TFLVerouden/cough-machine-control/docs/airflow/Valve 2 setpoint current and flow rate relation.pdf

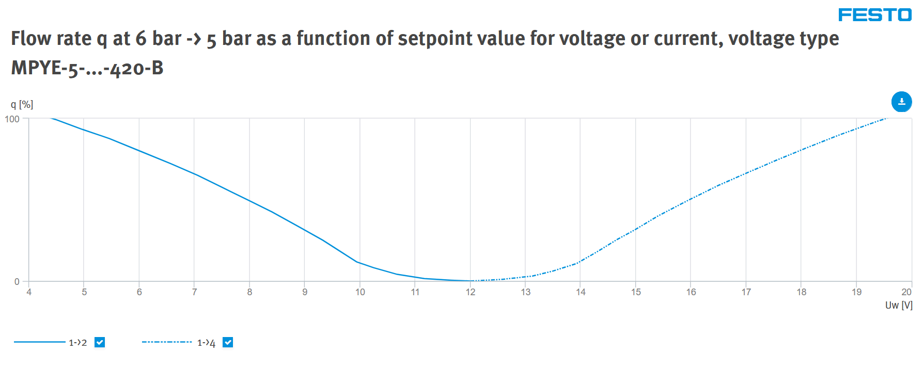
[picture p9: page 1]
