TFLVerouden/cough-machine-control/docs/peripherals/spraytec/SprayTec_support_alarm_at_low_signal.pdf

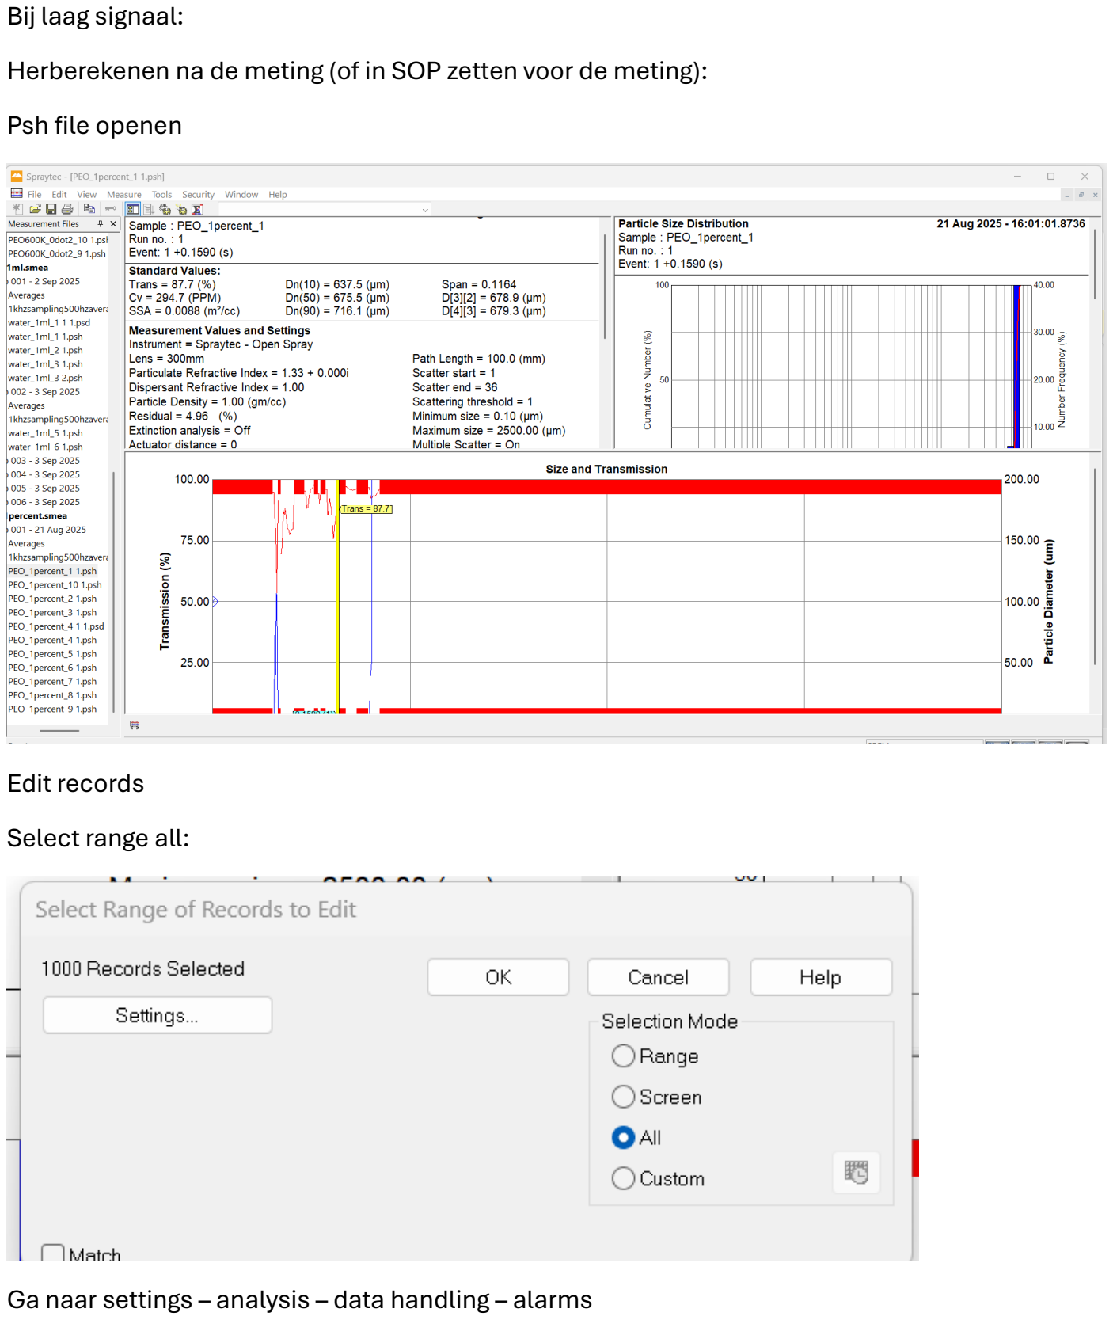
[picture p10: page 1]

Bij laag signaal:
Herberekenen na de meting (of in SOP zetten voor de meting): Psh file openen

Edit records
Select range all:

Ga naar settings – analysis – data handling – alarms

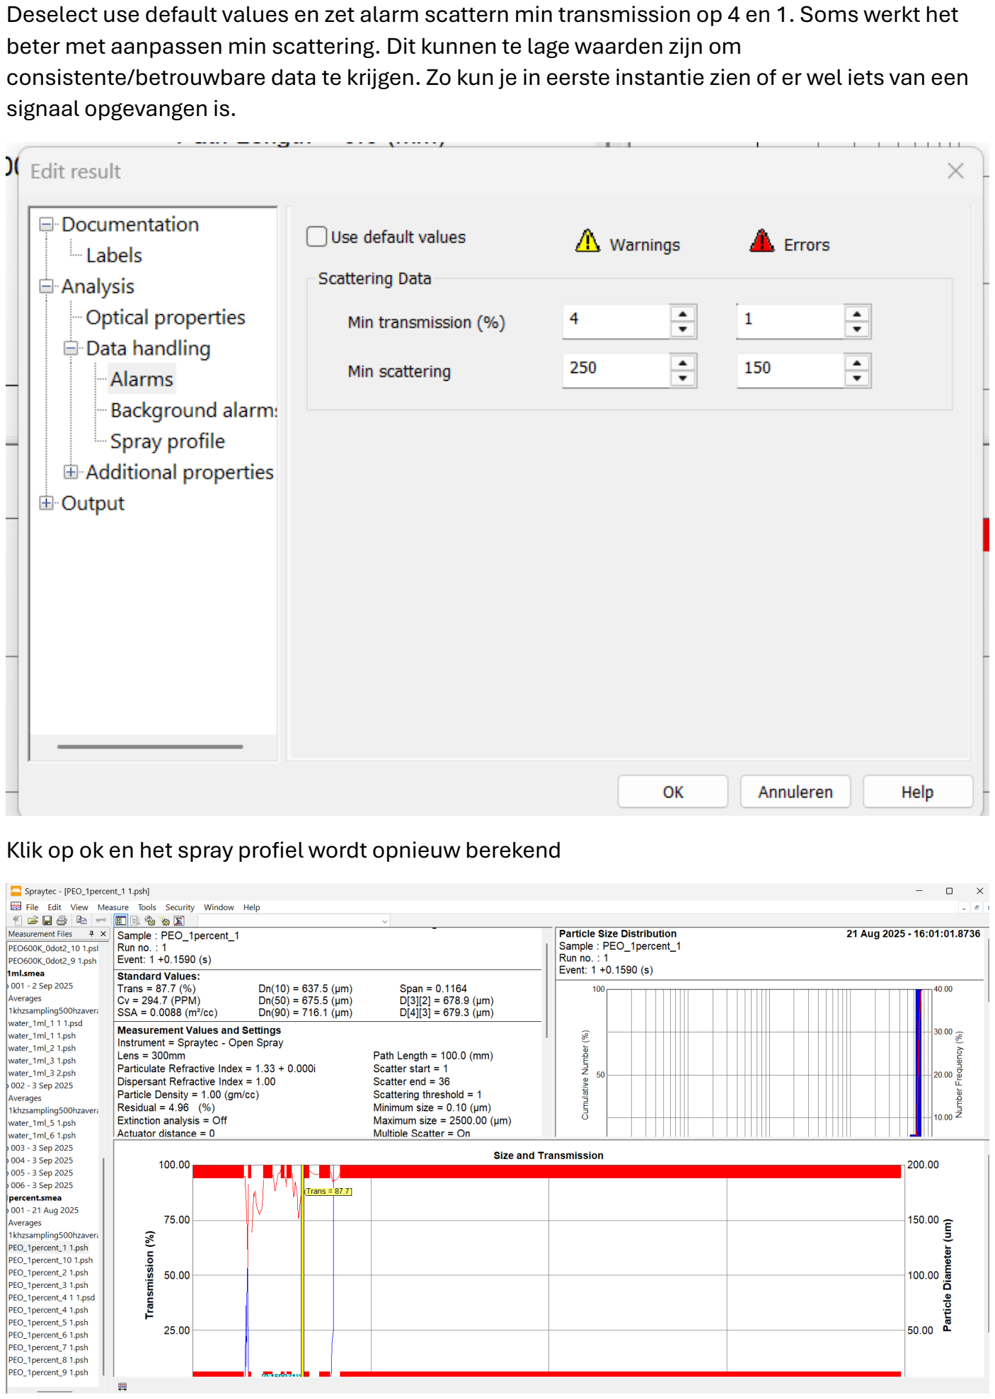
[picture p11: page 2]

Deselect use default values en zet alarm scattern min transmission op 4 en 1. Soms werkt het beter met aanpassen min scattering. Dit kunnen te lage waarden zijn om consistente/betrouwbare data te krijgen. Zo kun je in eerste instantie zien of er wel iets van een signaal opgevangen is.

Klik op ok en het spray profiel wordt opnieuw berekend
