TFLVerouden/cough-machine-control/data_to_local/piv/processed/PIV250723/PIV_1bar_80ms_closedtank/flow_rate.pdf

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

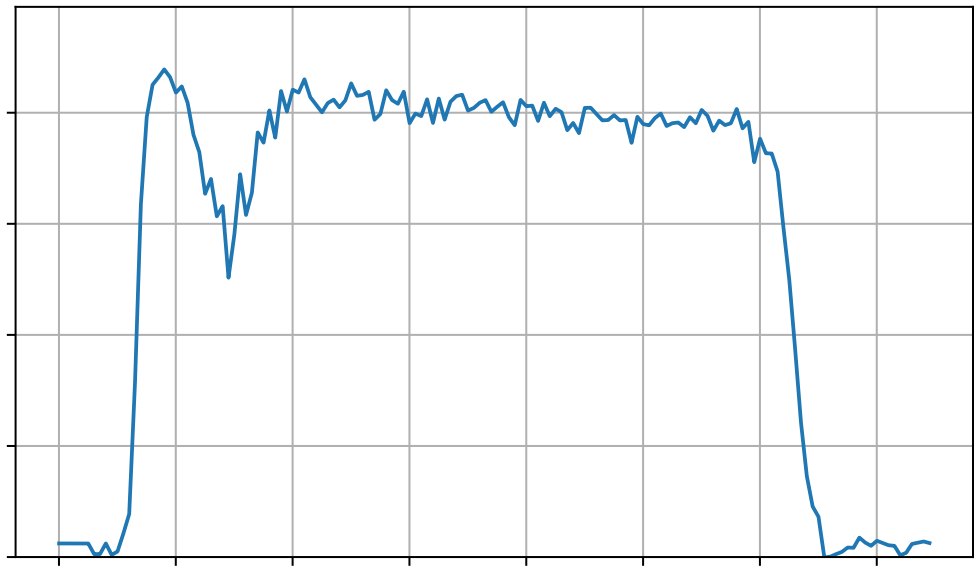
[picture p12: figure]
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
