TFLVerouden/cough-machine-control/archive/Ximea_experimenting/schematic_ximea_code_integration.pptx

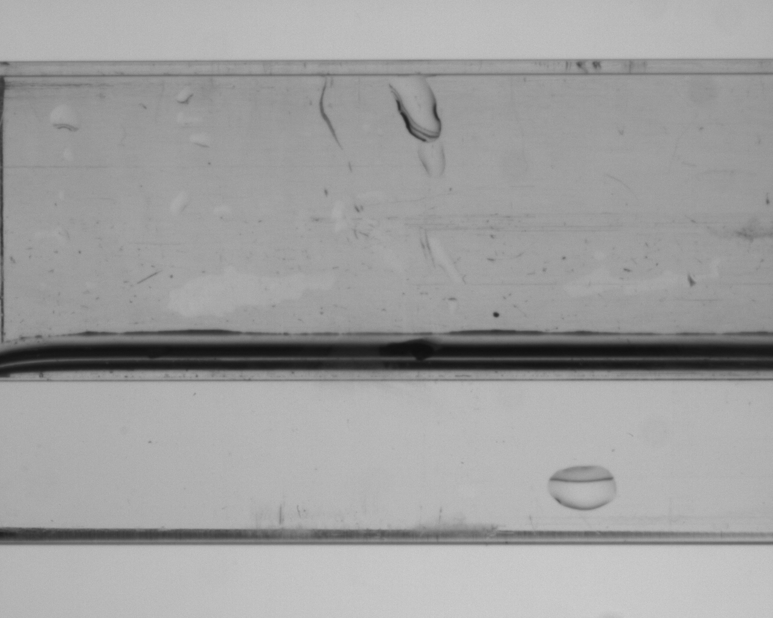
[picture p17: figure]
Afbeelding met Rechthoek, lijn, zwart-wit Door AI gegenereerde inhoud is mogelijk onjuist.

Live view

Valvecontrol

Satisfied? Type save or discard to continue
New question for Name of file

Discarding the live view

Asking to save the cough profile plus duration

Ready to cough?

Now: HS camera on second laptop.
Future? Opening of screen of desktop?
