TFLVerouden/cough-machine-control/data_to_local/valve_control_runs_outputs_to_be_sorted/250515_1322_emptythetank.png

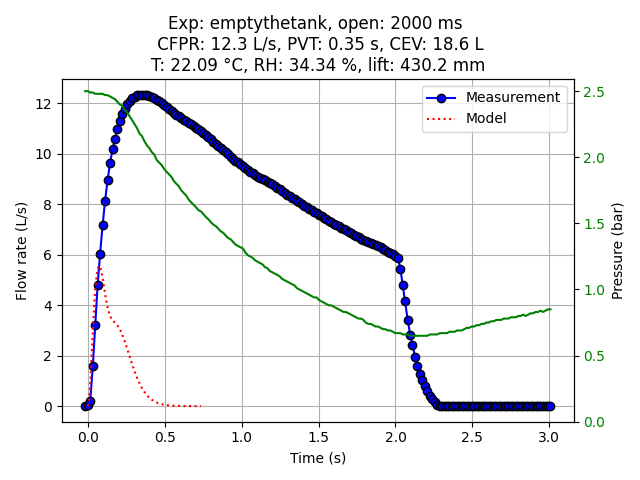
data_to_local/valve_control_runs_outputs_to_be_sorted/250515_1322_emptythetank.png
