TFLVerouden/cough-machine-control/data_to_local/valve_control_runs_outputs_to_be_sorted/250623_1608_PIV2.png

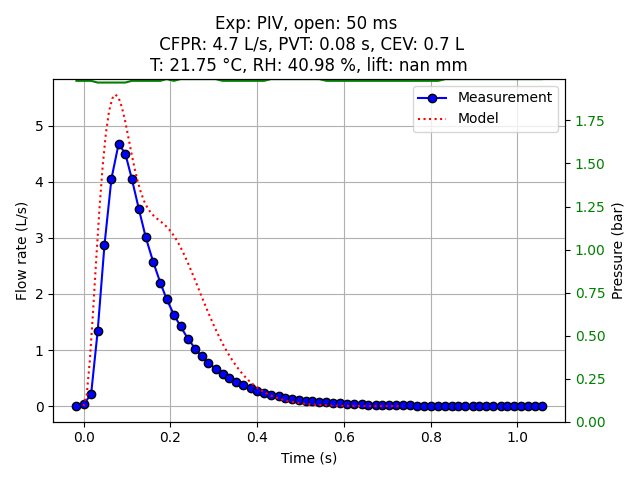
data_to_local/valve_control_runs_outputs_to_be_sorted/250623_1608_PIV2.png
