TFLVerouden/cough-machine-control/data_to_local/valve_control_runs_outputs_to_be_sorted/250624_1115_PIV3.png

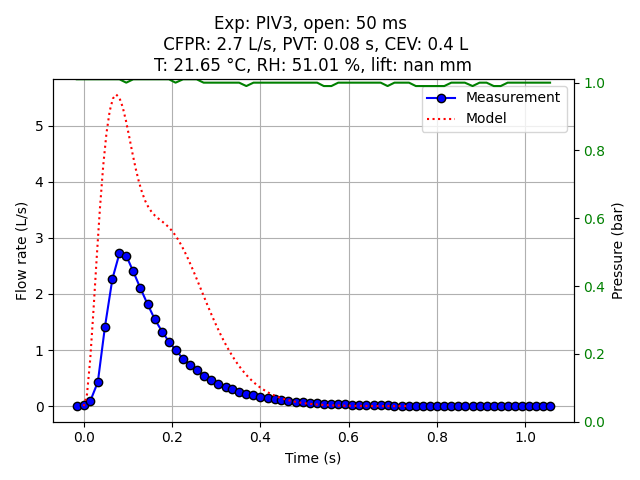
data_to_local/valve_control_runs_outputs_to_be_sorted/250624_1115_PIV3.png
