TFLVerouden/cough-machine-control/data_to_local/valve_control_runs_outputs_to_be_sorted/250624_1323_PIV7.png

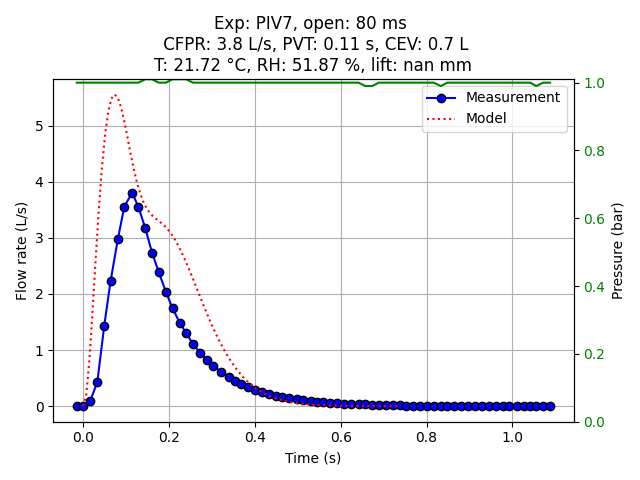
data_to_local/valve_control_runs_outputs_to_be_sorted/250624_1323_PIV7.png
