TFLVerouden/cough-machine-control/data_to_local/valve_control_runs_outputs_to_be_sorted/250626_1431_PIV10.png

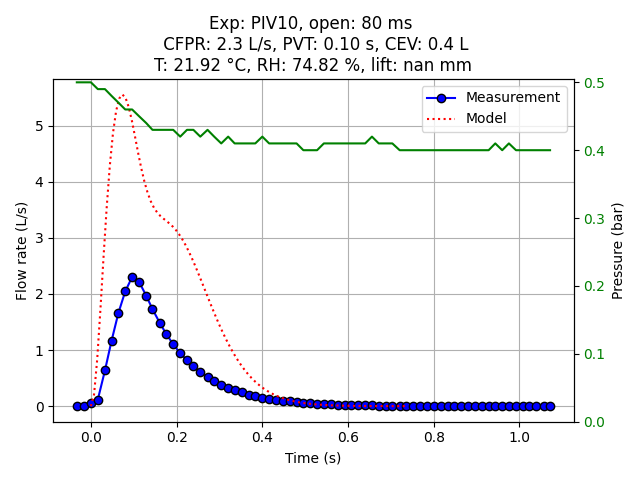
data_to_local/valve_control_runs_outputs_to_be_sorted/250626_1431_PIV10.png
