TFLVerouden/cough-machine-control/data_to_local/valve_control_runs_outputs_to_be_sorted/250626_1444_PIV11.png

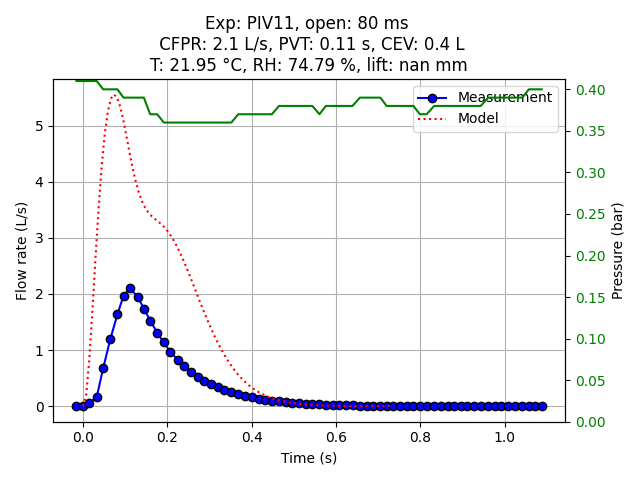
data_to_local/valve_control_runs_outputs_to_be_sorted/250626_1444_PIV11.png
