TFLVerouden/cough-machine-control/data_to_local/valve_control_runs_outputs_to_be_sorted/250704_1403_coughtopview0dot5bar0dot03percent.png

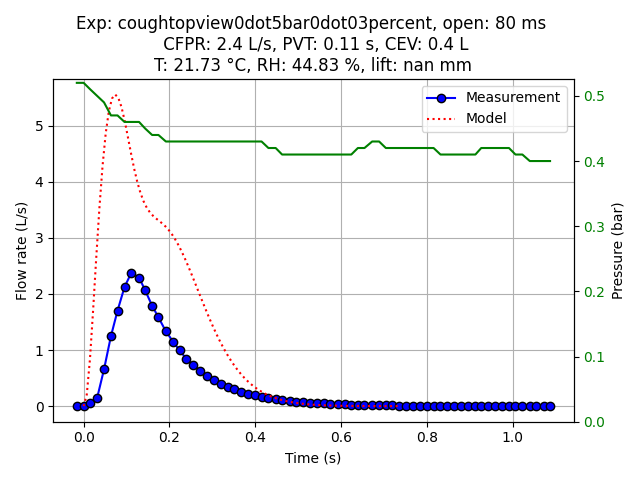
data_to_local/valve_control_runs_outputs_to_be_sorted/250704_1403_coughtopview0dot5bar0dot03percent.png
