TFLVerouden/cough-machine-control/data_to_local/valve_control_runs_outputs_to_be_sorted/250704_1427_cough_topview_0dot03percent_0dot5bar.png

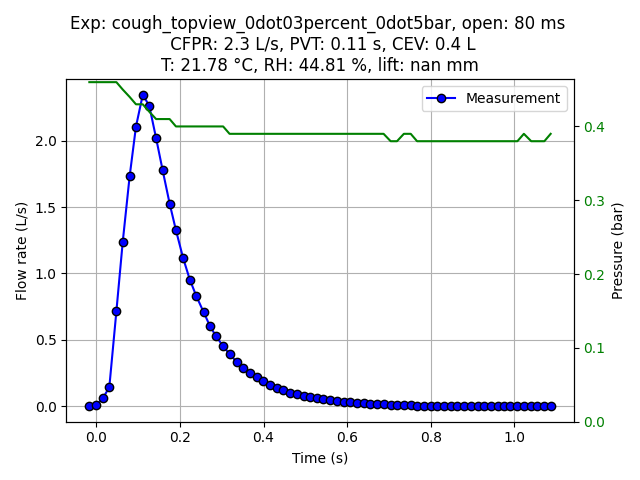
data_to_local/valve_control_runs_outputs_to_be_sorted/250704_1427_cough_topview_0dot03percent_0dot5bar.png
