TFLVerouden/cough-machine-control/data_to_local/valve_control_runs_outputs_to_be_sorted/250723_1517_PIV_1.5bar.png

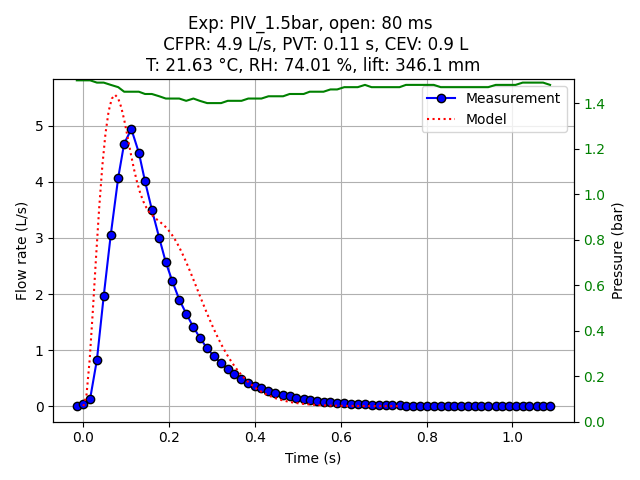
data_to_local/valve_control_runs_outputs_to_be_sorted/250723_1517_PIV_1.5bar.png
