TFLVerouden/cough-machine-control/data_to_local/valve_control_runs_outputs_to_be_sorted/250723_1638_1bar_refill.png

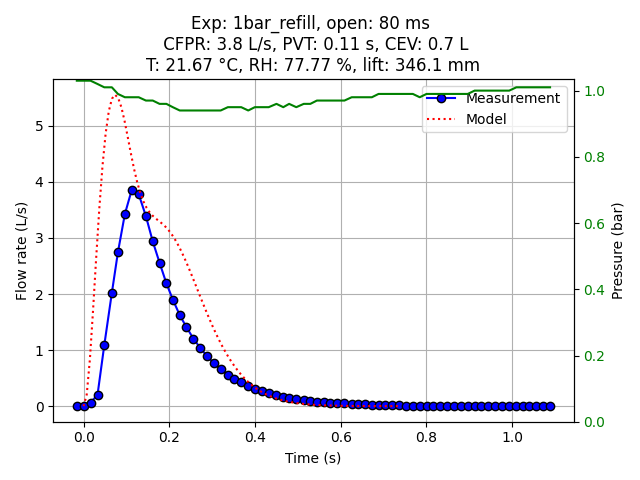
data_to_local/valve_control_runs_outputs_to_be_sorted/250723_1638_1bar_refill.png
