TFLVerouden/cough-machine-control/data_to_local/valve_control_runs_outputs_to_be_sorted/250801_1734_PEO0dot25_1dot5bar_1dot5ml_1.png

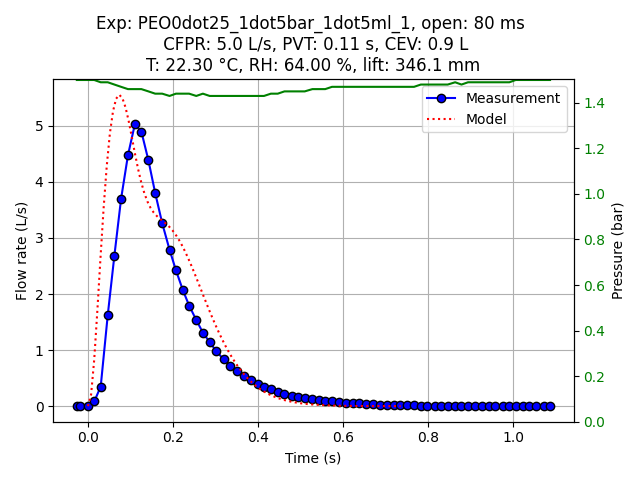
data_to_local/valve_control_runs_outputs_to_be_sorted/250801_1734_PEO0dot25_1dot5bar_1dot5ml_1.png
