TFLVerouden/cough-machine-control/data_to_local/valve_control_runs_outputs_to_be_sorted/250801_1807_1dot5bar_0dot25PEO_1dot5ml_2.png

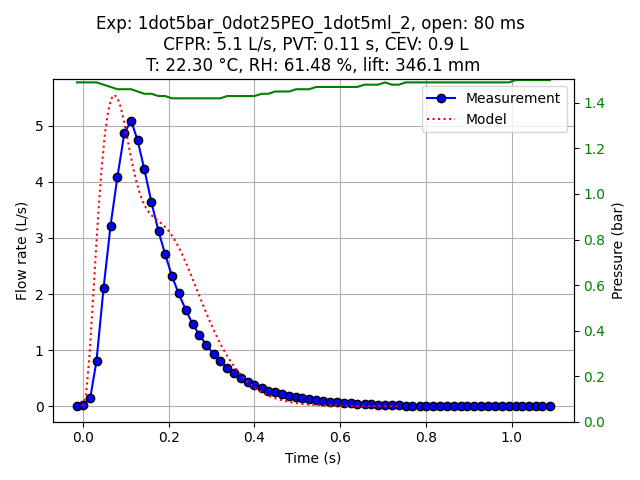
data_to_local/valve_control_runs_outputs_to_be_sorted/250801_1807_1dot5bar_0dot25PEO_1dot5ml_2.png
