TFLVerouden/cough-machine-control/data_to_local/valve_control_runs_outputs_to_be_sorted/250806_1147_PEO_0dot25_10.png

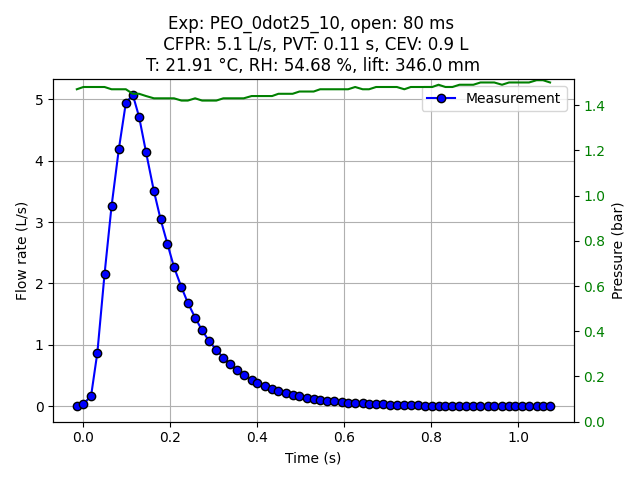
data_to_local/valve_control_runs_outputs_to_be_sorted/250806_1147_PEO_0dot25_10.png
