TFLVerouden/cough-machine-control/data_to_local/valve_control_runs_outputs_to_be_sorted/250807_1512_PEO0dot03_4.png

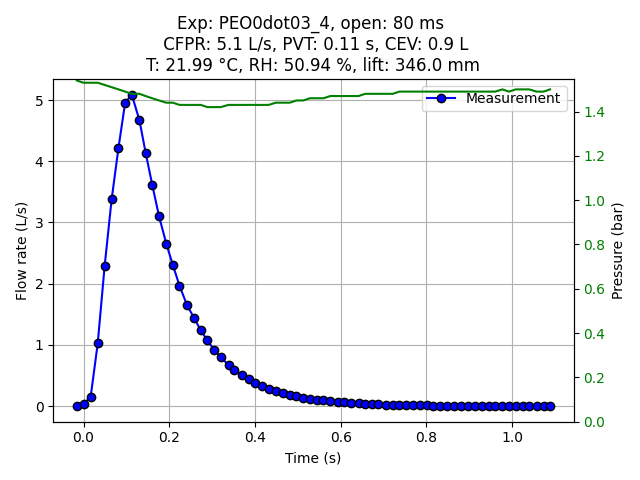
data_to_local/valve_control_runs_outputs_to_be_sorted/250807_1512_PEO0dot03_4.png
