TFLVerouden/cough-machine-control/data_to_local/valve_control_runs_outputs_to_be_sorted/250829_1744_PEO0dot25_0dot5bar_1.png

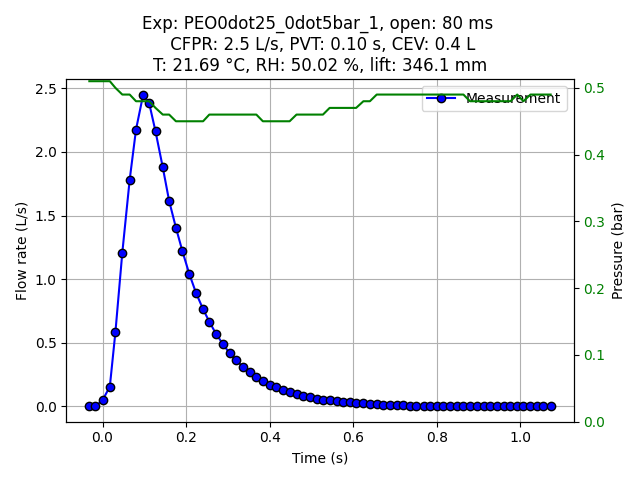
data_to_local/valve_control_runs_outputs_to_be_sorted/250829_1744_PEO0dot25_0dot5bar_1.png
