TFLVerouden/cough-machine-control/data_to_local/valve_control_runs_outputs_to_be_sorted/250829_1811_PEO0dot25_1dot25bar_2.png

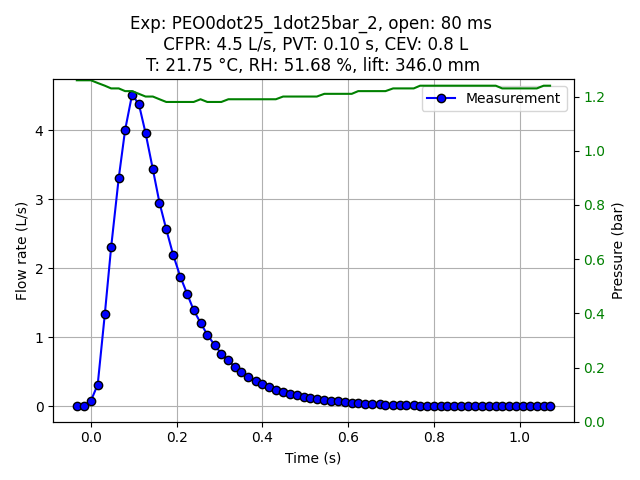
data_to_local/valve_control_runs_outputs_to_be_sorted/250829_1811_PEO0dot25_1dot25bar_2.png
