TFLVerouden/cough-machine-control/docs/electronics/screenshots/Adafruit_ItsyBitsy_M4_crop.PNG

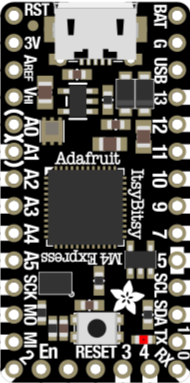
docs/electronics/screenshots/Adafruit_ItsyBitsy_M4_crop.PNG
