TFLVerouden/cough-machine-control/docs/electronics/screenshots/Adafruit_ItsyBitsy_M4_pinout.png

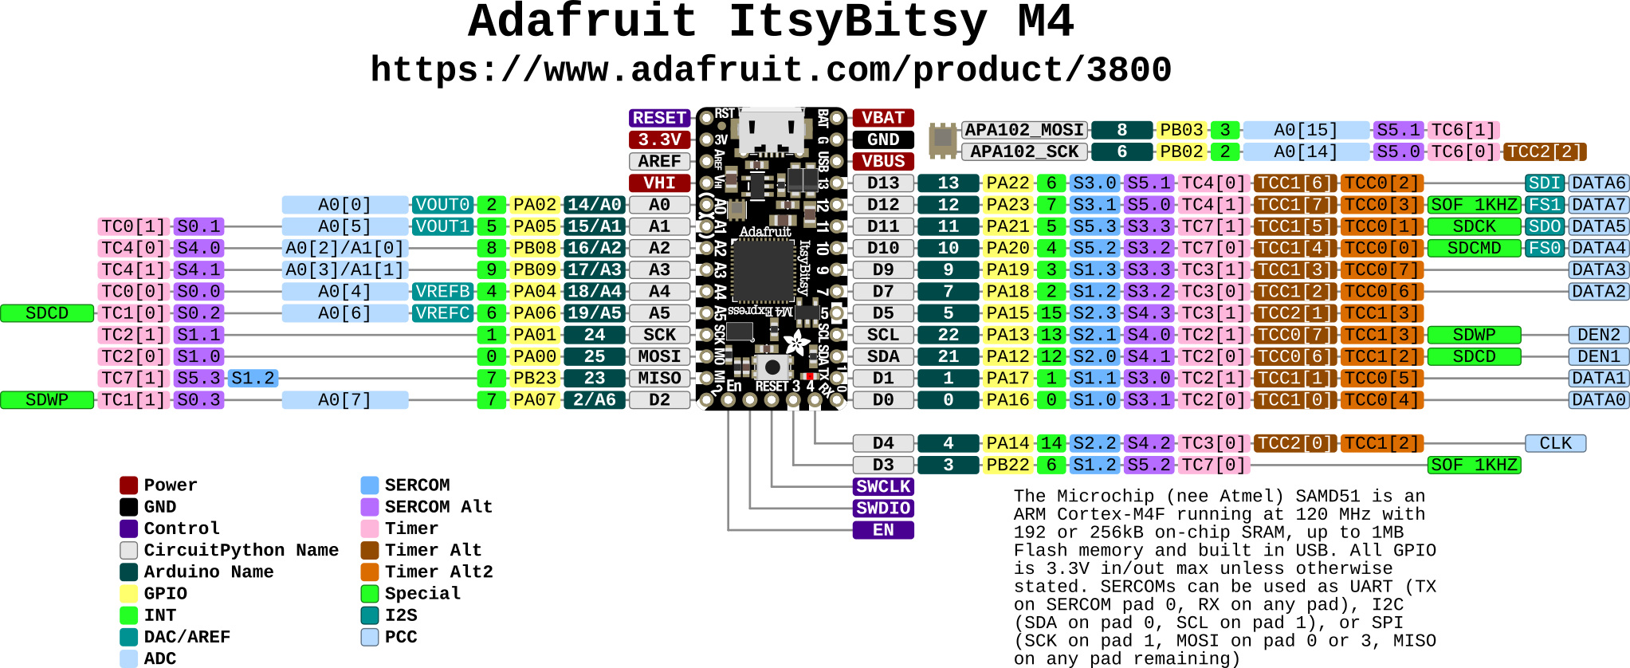
docs/electronics/screenshots/Adafruit_ItsyBitsy_M4_pinout.png
