TFLVerouden/cough-machine-control/docs/electronics/screenshots/Adafruit_Motor-MOSFET_driver_front.jpg

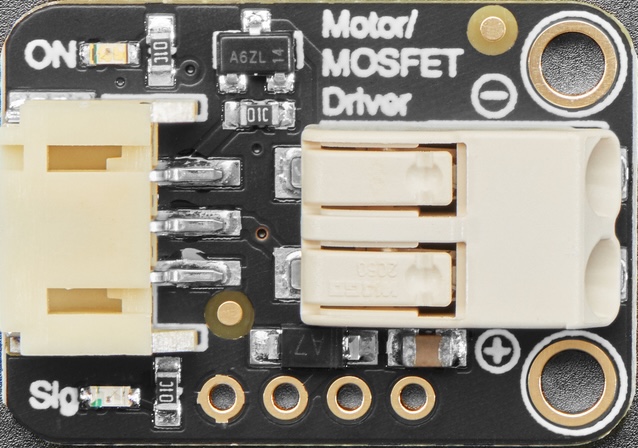
docs/electronics/screenshots/Adafruit_Motor-MOSFET_driver_front.jpg
