TFLVerouden/cough-machine-control/docs/electronics/screenshots/Adafruit_SHT45.jpg

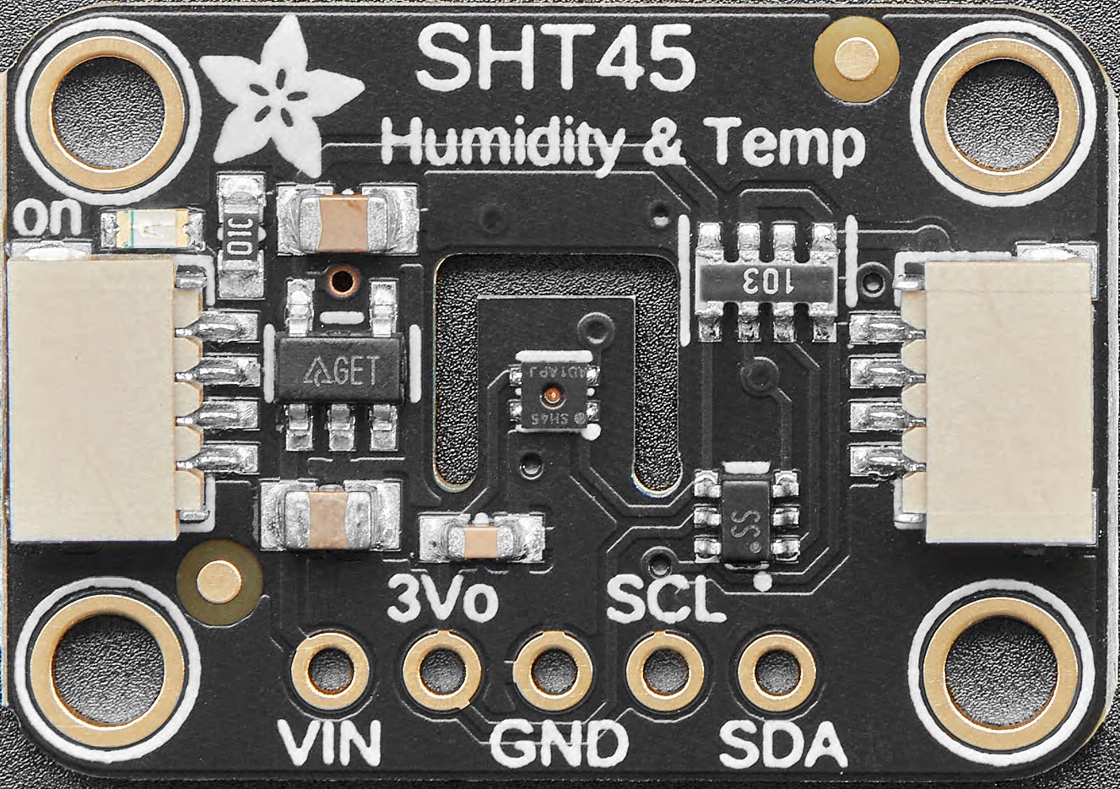
docs/electronics/screenshots/Adafruit_SHT45.jpg
