TFLVerouden/cough-machine-control/docs/electronics/screenshots/MIKROE_420mA_RClick_front.jpg

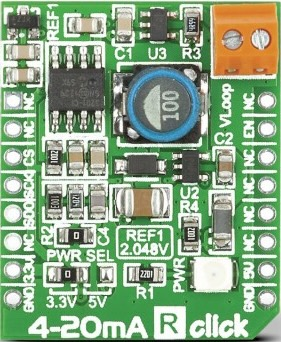
docs/electronics/screenshots/MIKROE_420mA_RClick_front.jpg
