TFLVerouden/cough-machine-control/docs/electronics/screenshots/MIKROE_420mA_TClick_back.jpg

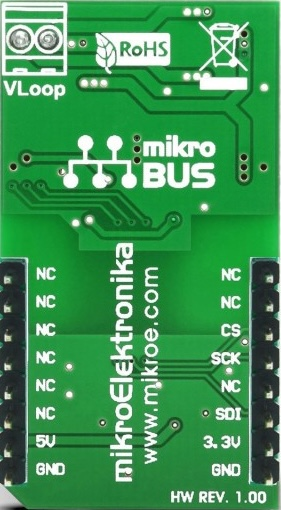
docs/electronics/screenshots/MIKROE_420mA_TClick_back.jpg
