TFLVerouden/cough-machine-control/docs/electronics/screenshots/MIKROE_420mA_TClick_front.jpg

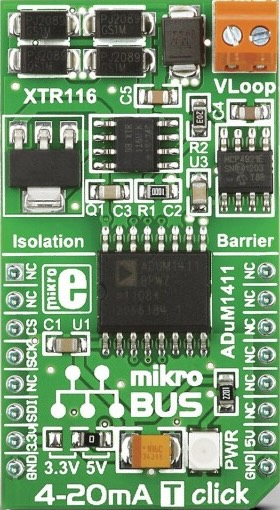
docs/electronics/screenshots/MIKROE_420mA_TClick_front.jpg
