TFLVerouden/cough-machine-control/other_side_stuff/effectofLEDlightonSpraytec.png

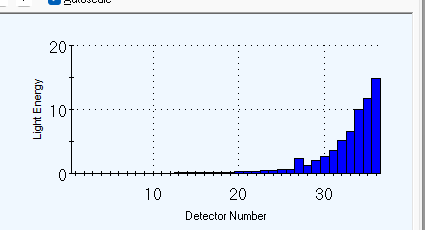
other_side_stuff/effectofLEDlightonSpraytec.png
