TFLVerouden/cough-machine-control/other_side_stuff/PIVplotter/flowmeter_Linnebank.png

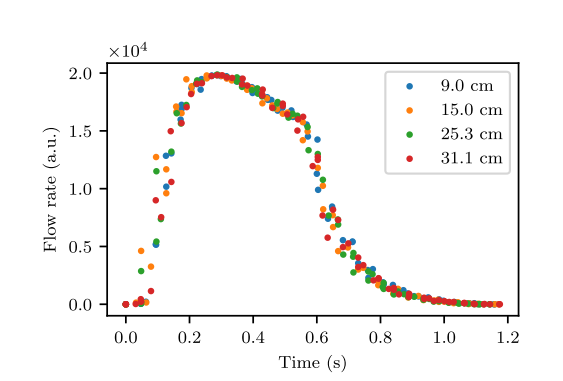
other_side_stuff/PIVplotter/flowmeter_Linnebank.png
