TFLVerouden/cough-machine-control/other_side_stuff/PIVplotter/PIV_Linnebank.png

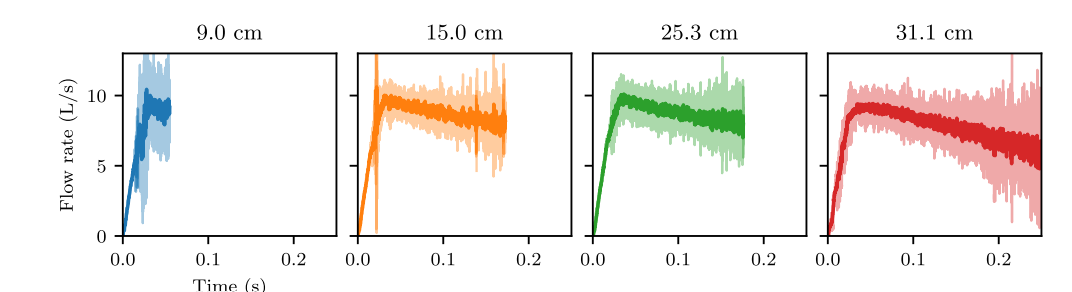
other_side_stuff/PIVplotter/PIV_Linnebank.png
