TFLVerouden/cough-machine-control/other_side_stuff/screenshotscamera/coughmachinecover615.png

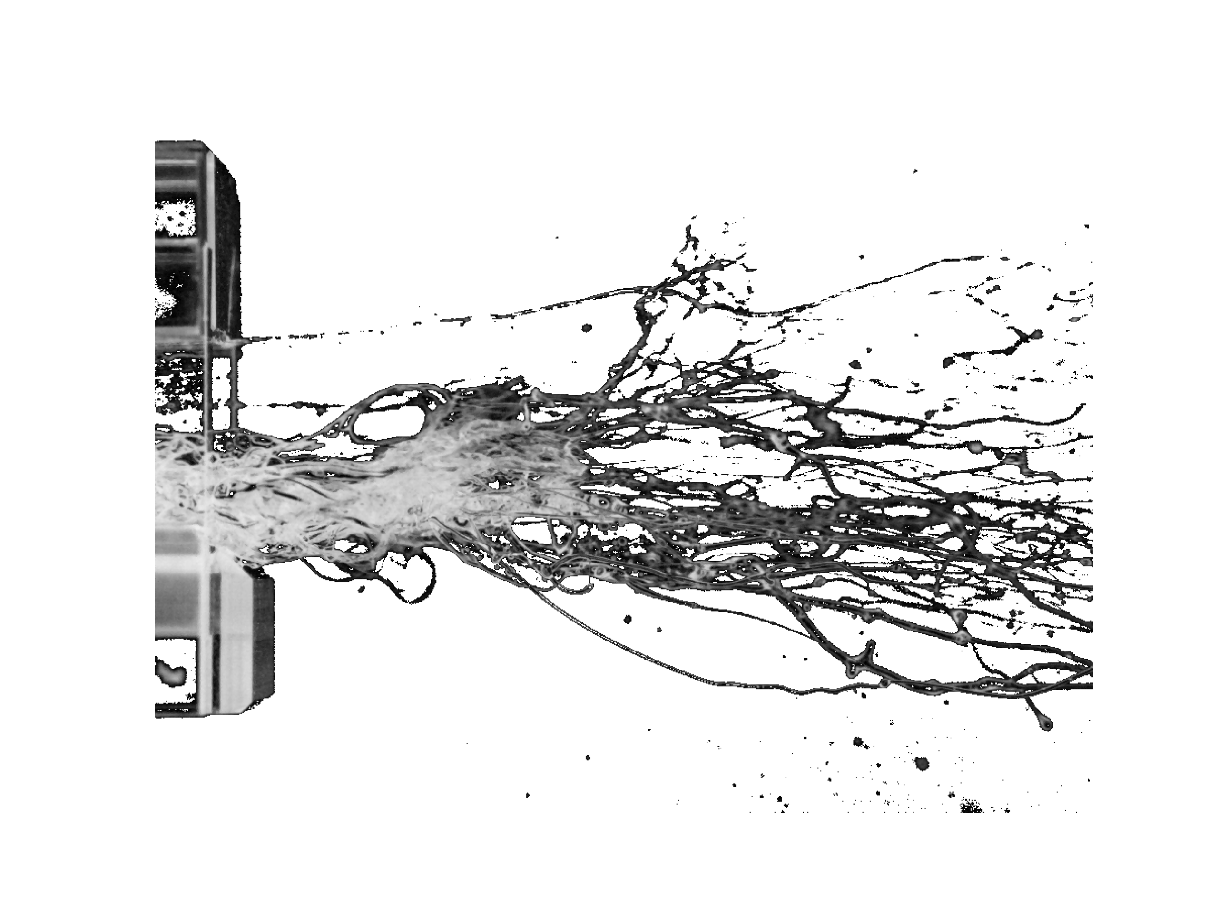
other_side_stuff/screenshotscamera/coughmachinecover615.png
