TFLVerouden/cough-machine-control/other_side_stuff/screenshotscamera/coughmachinecover1315.png

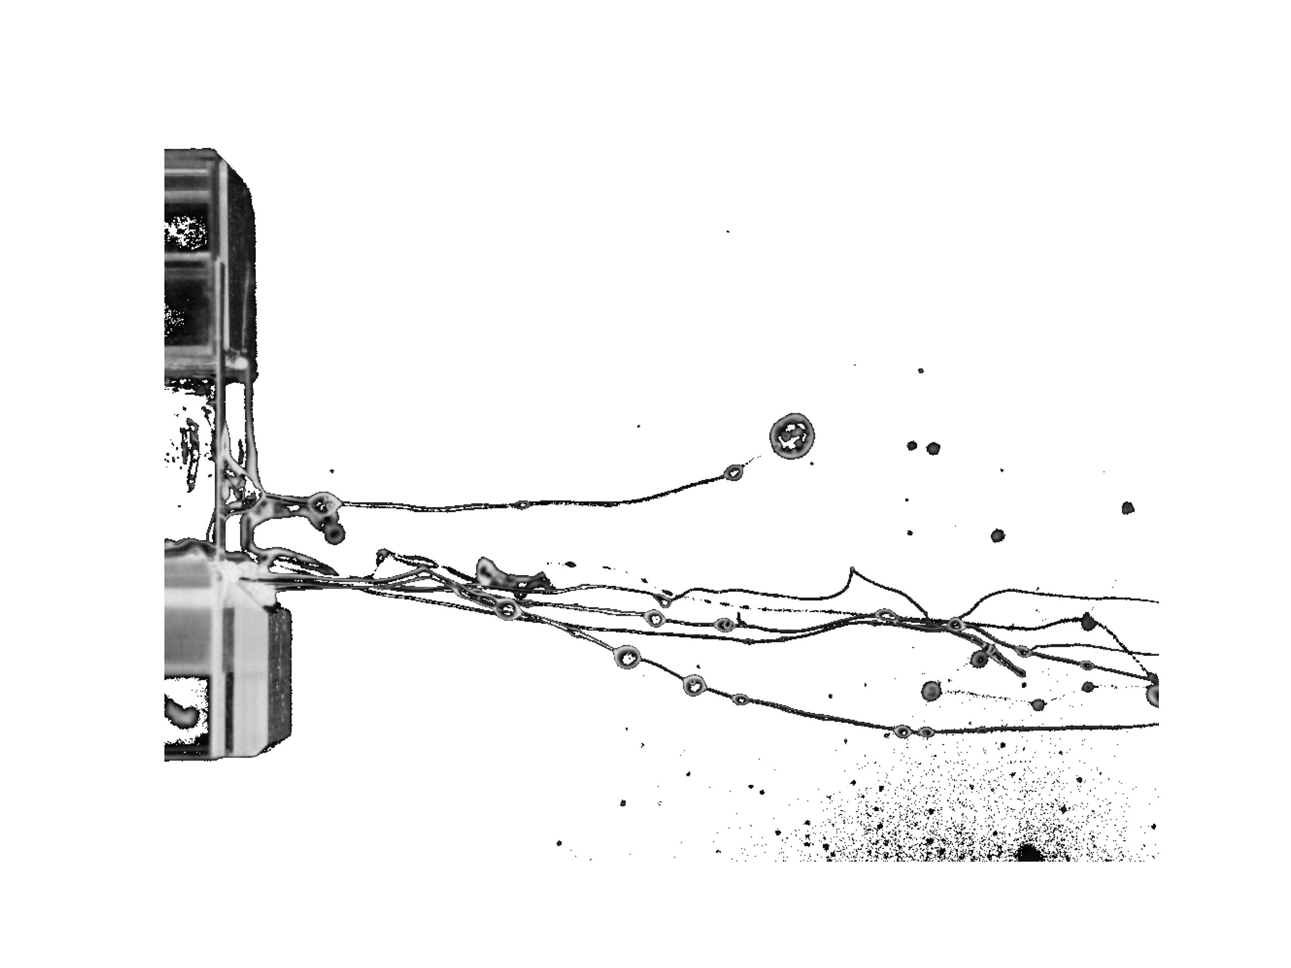
other_side_stuff/screenshotscamera/coughmachinecover1315.png
