TFLVerouden/cough-machine-control/other_side_stuff/screenshotscamera/coughmachinecover1515.png

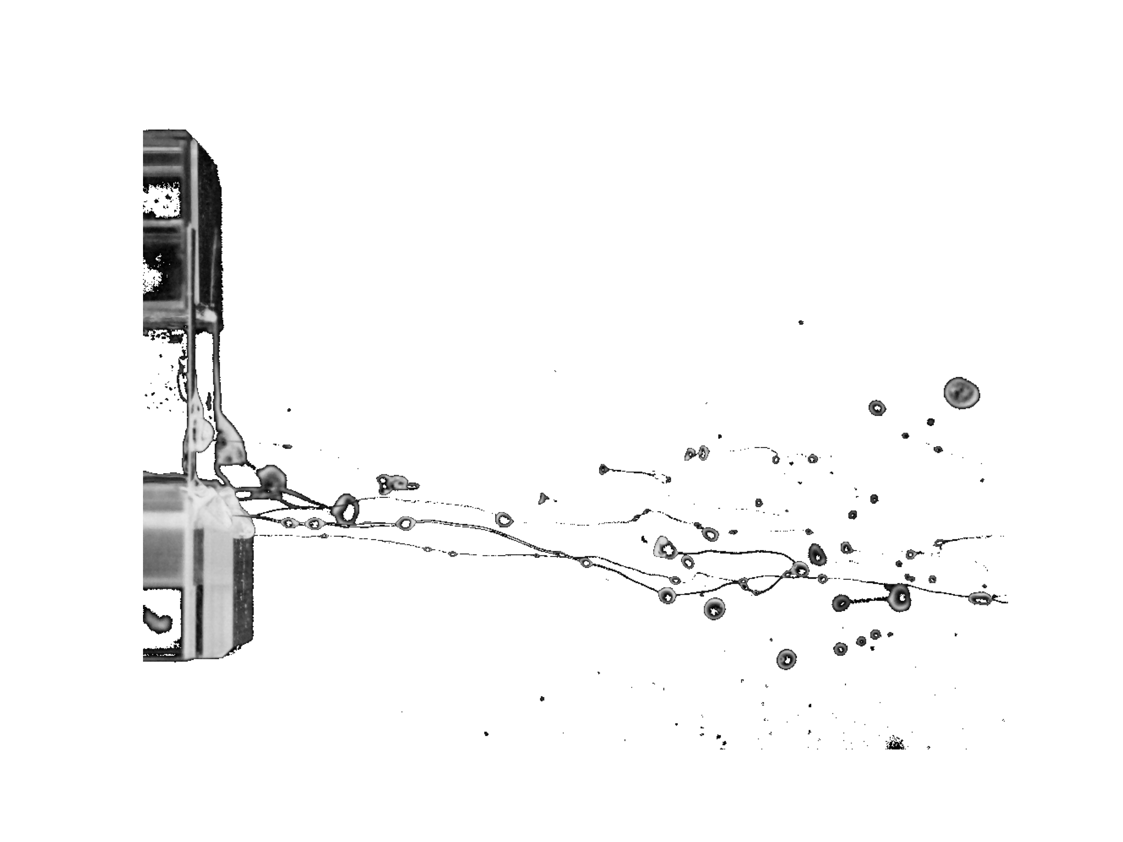
other_side_stuff/screenshotscamera/coughmachinecover1515.png
