TFLVerouden/cough-machine-control/other_side_stuff/screenshotscamera/coughmachinecover1815.png

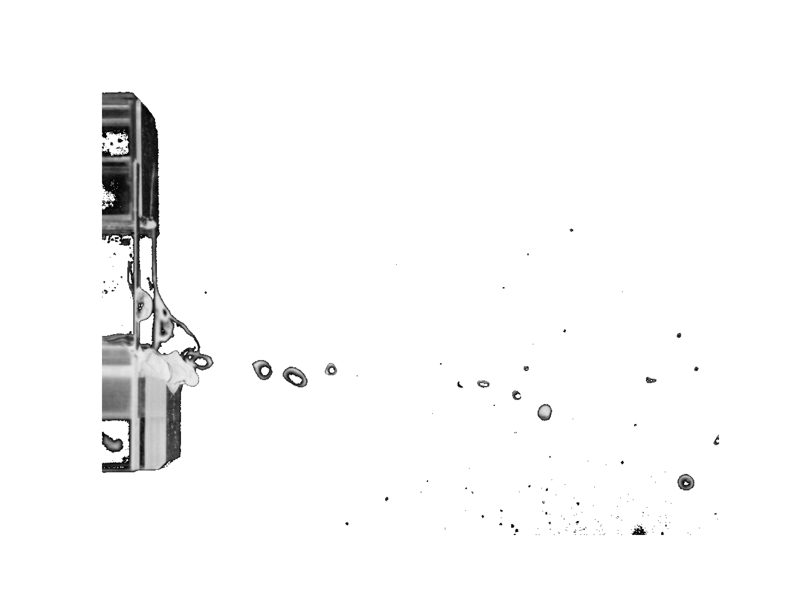
other_side_stuff/screenshotscamera/coughmachinecover1815.png
