TFLVerouden/cough-machine-control/other_side_stuff/screenshotscamera/sequencePEO0dot25720.png

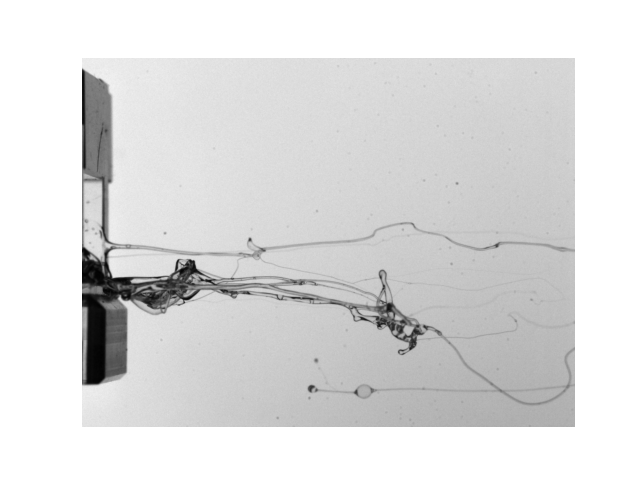
other_side_stuff/screenshotscamera/sequencePEO0dot25720.png
