TFLVerouden/cough-machine-control/other_side_stuff/screenshotscamera/sequencePEO0dot25920.png

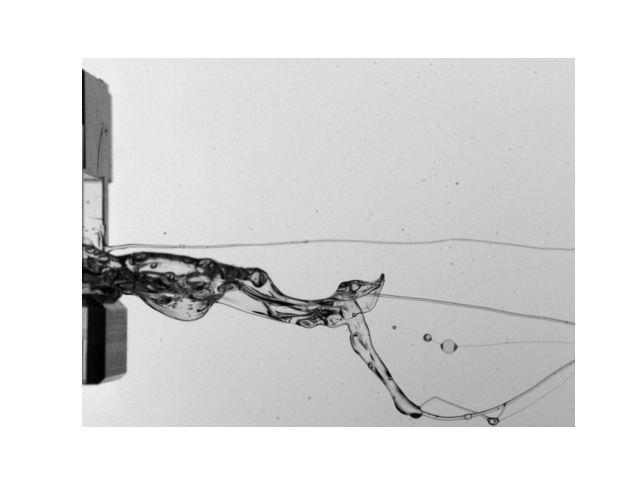
other_side_stuff/screenshotscamera/sequencePEO0dot25920.png
