TFLVerouden/cough-machine-control/other_side_stuff/screenshotscamera/sequencePEO0dot251120.png

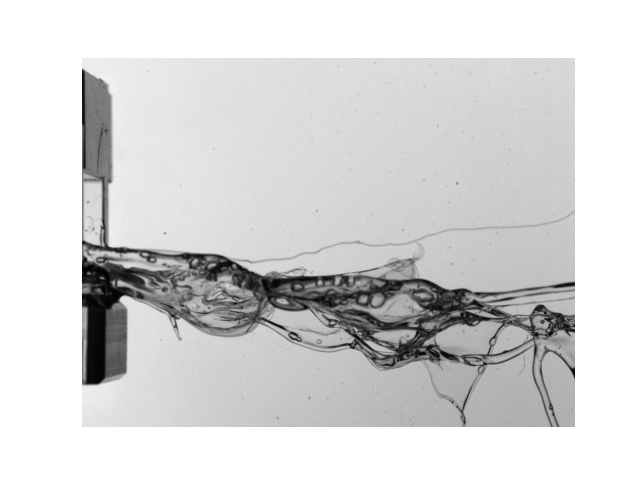
other_side_stuff/screenshotscamera/sequencePEO0dot251120.png
