TFLVerouden/cough-machine-control/other_side_stuff/screenshotscamera/watercover1589.png

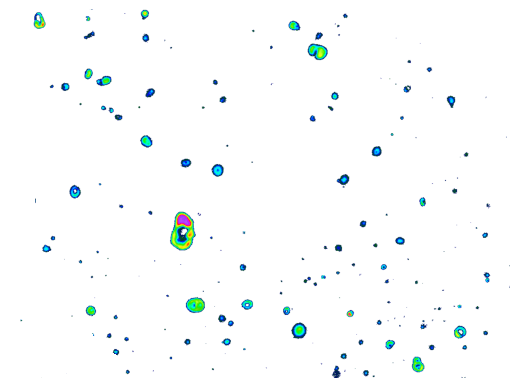
other_side_stuff/screenshotscamera/watercover1589.png
