TFLVerouden/cough-machine-control/other_side_stuff/screenshotscamera/watercoverblues1589.png

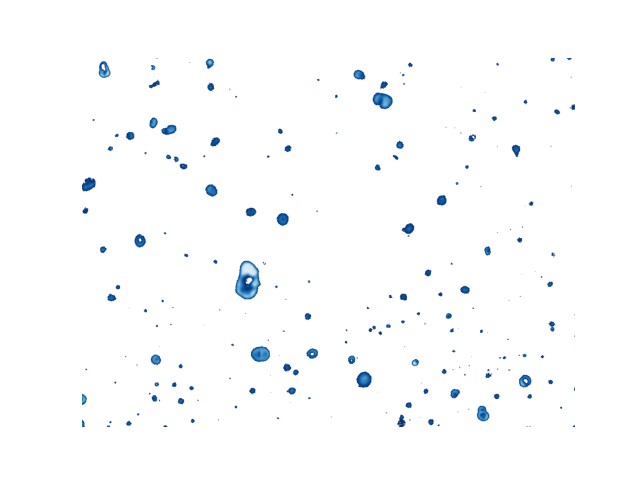
other_side_stuff/screenshotscamera/watercoverblues1589.png
