TFLVerouden/cough-machine-control/backup_flow_meter_readout/flow_meter_test.txt

tijd,meetwaarde
0.017,0
0.035,0
0.049,0
0.065,0
0.082,0
0.097,0
0.113,0
0.13,0
0.147,0
0.161,0
0.177,0
0.194,0
0.21,0
0.224,0
0.241,0
0.258,0
0.273,0
0.289,0
0.306,0
0.321,0
0.338,0
0.353,0
0.37,0
0.385,0
0.403,0
0.417,0
0.433,0
0.449,0
0.466,0
0.481,0
0.498,0
0.513,0
0.529,0
0.545,0
0.561,0
0.577,0
0.593,0
0.61,0
0.625,0
0.641,0
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
tijd,meetwaarde
0.01,0
0.027,0
0.043,0
0.057,0
0.074,0
0.09,0
0.106,0
0.122,0
0.138,0
0.155,0
0.169,0
0.186,0
0.202,0
0.218,0
0.234,0
0.252,0
0.266,0
0.283,0
0.298,0
0.314,0
0.33,0
0.346,0
0.361,0
0.378,0
0.394,0
0.41,0
0.426,0
0.442,0
0.458,0
0.474,0
0.49,0
0.506,0
0.521,0
0.538,0
0.554,0
0.569,0
0.586,0
0.602,0
0.618,0
0.634,0
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
tijd,meetwaarde
0.021,None
0.041,None
0.063,None
0.069,None
0.091,None
0.113,None
0.134,None
0.139,None
0.16,None
0.181,None
0.202,None
0.224,None
0.245,None
0.266,None
0.288,None
0.295,None
0.316,None
0.321,None
0.342,None
0.364,None
0.369,None
0.39,None
0.412,None
0.432,None
0.453,None
0.474,None
0.479,None
0.499,None
0.506,None
0.527,None
0.549,None
0.555,None
0.576,None
0.581,None
0.602,None
0.623,None
0.645,None
0.666,None
0.687,None
0.707,None
0.729,None
0.751,None
0.772,None
0.777,None
0.799,None
0.806,None
0.826,None
0.832,None
0.853,None
0.874,None
0.896,None
0.917,None
0.938,None
0.959,None
0.98,None
1.001,None
1.023,None
1.043,None
1.065,None
1.085,None
1.107,None
1.129,None
1.15,None
1.171,None
1.192,None
1.212,None
1.233,None
1.254,None
1.259,None
1.28,None
1.301,None
1.323,None
1.343,None
1.364,None
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
14.205,None
14.227,None
14.249,None
14.27,None
14.292,None
14.313,None
14.333,None
14.353,None
14.373,None
14.395,None
14.415,None
14.437,None
14.458,None
14.48,None
14.5,None
14.521,None
14.542,None
14.563,None
14.584,None
14.606,None
14.627,None
14.649,None
tijd,meetwaarde
0.019,0
0.035,0
0.05,0
0.067,0
0.083,0
0.099,0
0.115,0
0.131,0
0.147,0
0.162,0
0.179,0
0.195,0
0.211,0
0.227,0
0.243,0
0.258,0
0.275,0
0.29,0
0.307,0
0.323,0
0.339,0
0.355,0
0.372,0
0.403,0
0.419,0
0.434,0
0.45,0
0.468,0
0.483,0
0.499,0
0.515,0
0.531,0
0.547,0
0.563,0
0.58,0
0.595,0
0.612,0
0.627,0
0.643,0
0.659,0
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
