TFLVerouden/cough-machine-control/valve_control/arduino_tests/droplet_detection/test_data.txt

11:26:44.329 -> 4.047
11:26:44.329 -> 4.047
11:26:44.329 -> 4.042
11:26:44.360 -> 4.047
11:26:44.360 -> 4.047
11:26:44.360 -> 4.047
11:26:44.395 -> 4.042
11:26:44.395 -> 4.052
11:26:44.395 -> 4.057
11:26:44.432 -> 4.047
11:26:44.432 -> 4.057
11:26:44.432 -> 4.047
11:26:44.432 -> 4.047
11:26:44.464 -> 4.047
11:26:44.464 -> 4.042
11:26:44.464 -> 4.047
11:26:44.503 -> 4.042
11:26:44.503 -> 4.057
11:26:44.503 -> 4.052
11:26:44.536 -> 4.047
11:26:44.536 -> 4.052
11:26:44.536 -> 4.052
11:26:44.536 -> 4.047
11:26:44.568 -> 4.052
11:26:44.568 -> 4.047
11:26:44.568 -> 4.047
11:26:44.609 -> 4.052
11:26:44.609 -> 4.052
11:26:44.609 -> 4.071
11:26:44.609 -> 4.057
11:26:44.641 -> 4.062
11:26:44.641 -> 4.062
11:26:44.641 -> 4.067
11:26:44.673 -> 4.067
11:26:44.673 -> 4.067
11:26:44.673 -> 4.067
11:26:44.715 -> 4.067
11:26:44.715 -> 4.067
11:26:44.715 -> 4.067
11:26:44.715 -> 4.067
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
