TFLVerouden/cough-machine-control/other_side_stuff/PIVplotter/Results_flowmeter.csv

 | Area | Mean | Min | Max | X | Y | Angle | Length
1 | 0.000 | 83.000 | 83.000 | 83.000 | 0.436 | 8.200 | 0.000 | 0.000
2 | 0.000 | 124.000 | 124.000 | 124.000 | 0.453 | 8.043 | 0.000 | 0.000
3 | 0.000 | 223.000 | 223.000 | 223.000 | 0.464 | 7.864 | 0.000 | 0.000
4 | 0.000 | 255.000 | 255.000 | 255.000 | 0.468 | 7.542 | 0.000 | 0.000
5 | 0.000 | 132.000 | 132.000 | 132.000 | 0.470 | 7.201 | 0.000 | 0.000
6 | 0.000 | 255.000 | 255.000 | 255.000 | 0.481 | 6.771 | 0.000 | 0.000
7 | 0.000 | 255.000 | 255.000 | 255.000 | 0.481 | 6.323 | 0.000 | 0.000
8 | 0.000 | 98.000 | 98.000 | 98.000 | 0.499 | 5.821 | 0.000 | 0.000
9 | 0.000 | 255.000 | 255.000 | 255.000 | 0.506 | 5.319 | 0.000 | 0.000
10 | 0.000 | 255.000 | 255.000 | 255.000 | 0.514 | 4.889 | 0.000 | 0.000
11 | 0.000 | 132.000 | 132.000 | 132.000 | 0.520 | 4.530 | 0.000 | 0.000
12 | 0.000 | 83.000 | 83.000 | 83.000 | 0.533 | 4.082 | 0.000 | 0.000
13 | 0.000 | 236.000 | 236.000 | 236.000 | 0.541 | 3.580 | 0.000 | 0.000
14 | 0.000 | 83.000 | 83.000 | 83.000 | 0.556 | 3.078 | 0.000 | 0.000
15 | 0.000 | 110.000 | 110.000 | 110.000 | 0.570 | 2.774 | 0.000 | 0.000
16 | 0.000 | 98.000 | 98.000 | 98.000 | 0.589 | 2.523 | 0.000 | 0.000
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
