TFLVerouden/cough-machine-control/other_side_stuff/PIVplotter/Results_PIV.csv

 | Area | Mean | Min | Max | X | Y | Angle | Length
1 | 0.000 | 98.000 | 98.000 | 98.000 | 0.972 | 16.341 | 0 | 0.000
2 | 0.000 | 98.000 | 98.000 | 98.000 | 0.974 | 15.952 | 0 | 0.000
3 | 0.000 | 98.000 | 98.000 | 98.000 | 0.975 | 15.687 | 0 | 0.000
4 | 0.000 | 98.000 | 98.000 | 98.000 | 0.975 | 15.369 | 0 | 0.000
5 | 0.000 | 98.000 | 98.000 | 98.000 | 0.976 | 15.051 | 0 | 0.000
6 | 0.000 | 98.000 | 98.000 | 98.000 | 0.977 | 14.769 | 0 | 0.000
7 | 0.000 | 98.000 | 98.000 | 98.000 | 0.979 | 14.415 | 0 | 0.000
8 | 0.000 | 98.000 | 98.000 | 98.000 | 0.977 | 14.097 | 0 | 0.000
9 | 0.000 | 98.000 | 98.000 | 98.000 | 0.979 | 13.691 | 0 | 0.000
10 | 0.000 | 98.000 | 98.000 | 98.000 | 0.979 | 13.373 | 0 | 0.000
11 | 0.000 | 98.000 | 98.000 | 98.000 | 0.981 | 13.143 | 0 | 0.000
12 | 0.000 | 98.000 | 98.000 | 98.000 | 0.982 | 12.772 | 0 | 0.000
13 | 0.000 | 98.000 | 98.000 | 98.000 | 0.984 | 12.295 | 0 | 0.000
14 | 0.000 | 98.000 | 98.000 | 98.000 | 0.985 | 11.783 | 0 | 0.000
15 | 0.000 | 98.000 | 98.000 | 98.000 | 0.987 | 11.430 | 0 | 0.000
16 | 0.000 | 98.000 | 98.000 | 98.000 | 0.987 | 11.129 | 0 | 0.000
17 | 0.000 | 98.000 | 98.000 | 98.000 | 0.987 | 10.811 | 0 | 0.000
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
