TFLVerouden/cough-machine-control/data_to_local/results_abe/2_5bar50ms.csv

Experiment name | test
Start time (UTC) | 2025-03-24 15:33:19.367622+00:00
Opening duration (ms) | 50
Time before opening (ms) | 500
Time after closing (ms) | 1000
Ambient Temperature (Celsius) | 22.31
Relative Humidity (%) | 40.56
Elapsed time (s) | Pressure (bar) | Flow rate (L/s)
-0.5269067287445068 | 0.0 | 0.0
-0.5105845928192139 | 0.0 | 0.0
-0.49484825134277344 | 0.0 | 0.0
-0.4796113967895508 | 0.0 | 0.0
-0.4628725051879883 | 0.0 | 0.0
-0.4472389221191406 | 0.0 | 0.0
-0.4312605857849121 | 0.0 | 0.0
-0.4153439998626709 | 0.0 | 0.0
-0.40023326873779297 | 0.0 | 0.0
-0.3837094306945801 | 0.0 | 0.0
-0.3673574924468994 | 0.0 | 0.0
-0.3502192497253418 | 0.0 | 0.0
-0.3354990482330322 | 0.0 | 0.0
-0.3180985450744629 | 0.0 | 0.0
-0.30303406715393066 | 0.0 | 0.0
-0.2880983352661133 | 0.0 | 0.0
-0.27036499977111816 | 0.0 | 0.0
-0.25484776496887207 | 0.0 | 0.0
-0.23962926864624023 | 0.0 | 0.0
-0.2233884334564209 | 0.0 | 0.0
-0.20705747604370117 | 0.0 | 0.0
-0.19049978256225586 | 0.0 | 0.0
-0.17383146286010742 | 0.0 | 0.0
-0.15900850296020508 | 0.0 | 0.0
-0.14429879188537598 | 0.0 | 0.0
-0.12641024589538574 | 0.0 | 0.0
-0.11153602600097656 | 0.0 | 0.0
-0.09480929374694824 | 0.0 | 0.0
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
