TFLVerouden/cough-machine-control/data_to_local/experiments/050325_plasmacleanedtests/250305_1435_2_5bar_50ms.csv

Experiment name | 2_5bar_50ms
Start time (UTC) | 2025-03-05 13:35:53.243082+00:00
Opening duration (ms) | 50
Time before opening (ms) | 500
Time after closing (ms) | 1000
Ambient Temperature (Celsius) | 21.60
Relative Humidity (%) | 33.75
Elapsed time (s) | Pressure (bar) | Flow rate (L/s)
-0.5279793739318848 | 0.0 | 0.0
-0.5130317211151123 | 0.0 | 0.0
-0.49531006813049316 | 0.0 | 0.0
-0.48065781593322754 | 0.0 | 0.0
-0.46414613723754883 | 0.0 | 0.0
-0.44814634323120117 | 0.0 | 0.0
-0.43293118476867676 | 0.0 | 0.0
-0.4155552387237549 | 0.0 | 0.0
-0.4006025791168213 | 0.0 | 0.0
-0.3843972682952881 | 0.0 | 0.0
-0.3690507411956787 | 0.0 | 0.0
-0.3525559902191162 | 0.0 | 0.0
-0.33701157569885254 | 0.0 | 0.0
-0.3210313320159912 | 0.0 | 0.0
-0.3044106960296631 | 0.0 | 0.0
-0.28874921798706055 | 0.0 | 0.0
-0.2726438045501709 | 0.0 | 0.0
-0.25725769996643066 | 0.0 | 0.0
-0.24038100242614746 | 0.0 | 0.0
-0.22540688514709473 | 0.0 | 0.0
-0.20818209648132324 | 0.0 | 0.0
-0.1929607391357422 | 0.0 | 0.0
-0.17715930938720703 | 0.0 | 0.0
-0.16125869750976562 | 0.0 | 0.0
-0.14358234405517578 | 0.0 | 0.0
-0.12895870208740234 | 0.0 | 0.0
-0.11260700225830078 | 0.0 | 0.0
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
