TFLVerouden/cough-machine-control/data_to_local/experiments/250324_etpof_droplets/250324_1028_ETPoF_1-32_1.csv

Experiment name | ETPoF_1-32_1
Start time (UTC) | 2025-03-24 09:28:51.623677+00:00
Opening duration (ms) | 50
Time before opening (ms) | 500
Time after closing (ms) | 1000
Ambient Temperature (Celsius) | 22.51
Relative Humidity (%) | 43.75
Elapsed time (s) | Pressure (bar) | Flow rate (L/s)
-0.5295171737670898 | 0.0 | 0.0
-0.5107097625732422 | 0.0 | 0.0
-0.4937899112701416 | 0.0 | 0.0
-0.47798609733581543 | 0.0 | 0.0
-0.4622476100921631 | 0.0 | 0.0
-0.4475085735321045 | 0.0 | 0.0
-0.43122291564941406 | 0.0 | 0.0
-0.41541481018066406 | 0.0 | 0.0
-0.3989884853363037 | 0.0 | 0.0
-0.3822786808013916 | 0.0 | 0.0
-0.366985559463501 | 0.0 | 0.0
-0.3518953323364258 | 0.0 | 0.0
-0.3351747989654541 | 0.0 | 0.0
-0.3193366527557373 | 0.0 | 0.0
-0.3022329807281494 | 0.0 | 0.0
-0.2865304946899414 | 0.0 | 0.0
-0.27152585983276367 | 0.0 | 0.0
-0.25351953506469727 | 0.0 | 0.0
-0.23825311660766602 | 0.0 | 0.0
-0.22182703018188477 | 0.0 | 0.0
-0.2077326774597168 | 0.0 | 0.0
-0.1912693977355957 | 0.0 | 0.0
-0.17546486854553223 | 0.0 | 0.0
-0.15891647338867188 | 0.0 | 0.0
-0.1431868076324463 | 0.0 | 0.0
-0.127854585647583 | 0.0 | 0.0
-0.1104118824005127 | 0.0 | 0.0
-0.09480524063110352 | 0.0 | 0.0
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
