TFLVerouden/cough-machine-control/data_to_local/experiments/250324_etpof_droplets/250324_1048_ETPoF_1-32_2.csv

Experiment name | ETPoF_1-32_2
Start time (UTC) | 2025-03-24 09:48:01.811968+00:00
Opening duration (ms) | 50
Time before opening (ms) | 500
Time after closing (ms) | 1000
Ambient Temperature (Celsius) | 22.44
Relative Humidity (%) | 43.39
Elapsed time (s) | Pressure (bar) | Flow rate (L/s)
-0.5276222229003906 | 0.0 | 0.0
-0.5125830173492432 | 0.0 | 0.0
-0.49605822563171387 | 0.0 | 0.0
-0.48035192489624023 | 0.0 | 0.0
-0.46434903144836426 | 0.0 | 0.0
-0.4484748840332031 | 0.0 | 0.0
-0.4319586753845215 | 0.0 | 0.0
-0.41677212715148926 | 0.0 | 0.0
-0.40033984184265137 | 0.0 | 0.0
-0.38489532470703125 | 0.0 | 0.0
-0.36887478828430176 | 0.0 | 0.0
-0.3525688648223877 | 0.0 | 0.0
-0.3377878665924072 | 0.0 | 0.0
-0.3193321228027344 | 0.0 | 0.0
-0.3043539524078369 | 0.0 | 0.0
-0.2894294261932373 | 0.0 | 0.0
-0.27290940284729004 | 0.0 | 0.0
-0.2559487819671631 | 0.0 | 0.0
-0.2414093017578125 | 0.0 | 0.0
-0.2244577407836914 | 0.0 | 0.0
-0.20884251594543457 | 0.0 | 0.0
-0.19317197799682617 | 0.0 | 0.0
-0.17658495903015137 | 0.0 | 0.0
-0.16141247749328613 | 0.0 | 0.0
-0.14514732360839844 | 0.0 | 0.0
-0.1289980411529541 | 0.0 | 0.0
-0.11305999755859375 | 0.0 | 0.0
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
