TFLVerouden/cough-machine-control/data_to_local/experiments/250324_etpof_droplets/250324_1057_ETPoF_1-32_3.csv

Experiment name | ETPoF_1-32_3
Start time (UTC) | 2025-03-24 09:57:26.614287+00:00
Opening duration (ms) | 50
Time before opening (ms) | 500
Time after closing (ms) | 1000
Ambient Temperature (Celsius) | 22.49
Relative Humidity (%) | 43.00
Elapsed time (s) | Pressure (bar) | Flow rate (L/s)
-0.5206966400146484 | 0.0 | 0.0
-0.5109529495239258 | 0.0 | 0.0
-0.4956223964691162 | 0.0 | 0.0
-0.47908616065979004 | 0.0 | 0.0
-0.46318888664245605 | 0.0 | 0.0
-0.44707632064819336 | 0.0 | 0.0
-0.4313328266143799 | 0.0 | 0.0
-0.41530466079711914 | 0.0 | 0.0
-0.39897608757019043 | 0.0 | 0.0
-0.38372111320495605 | 0.0 | 0.0
-0.36775875091552734 | 0.0 | 0.0
-0.35148191452026367 | 0.0 | 0.0
-0.335770845413208 | 0.0 | 0.0
-0.32024192810058594 | 0.0 | 0.0
-0.3038825988769531 | 0.0 | 0.0
-0.2874917984008789 | 0.0 | 0.0
-0.2719893455505371 | 0.0 | 0.0
-0.25498127937316895 | 0.0 | 0.0
-0.239349365234375 | 0.0 | 0.0
-0.22307872772216797 | 0.0 | 0.0
-0.2066974639892578 | 0.0 | 0.0
-0.19119834899902344 | 0.0 | 0.0
-0.17458868026733398 | 0.0 | 0.0
-0.15848016738891602 | 0.0 | 0.0
-0.14339184761047363 | 0.0 | 0.0
-0.12628817558288574 | 0.0 | 0.0
-0.1111440658569336 | 0.0 | 0.0
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
