TFLVerouden/cough-machine-control/data_to_local/experiments/250324_etpof_droplets/250324_1137_ETPoF_1-8_1.csv

Experiment name | ETPoF_1-8_1
Start time (UTC) | 2025-03-24 10:37:26.793657+00:00
Opening duration (ms) | 50
Time before opening (ms) | 500
Time after closing (ms) | 1000
Ambient Temperature (Celsius) | 22.61
Relative Humidity (%) | 43.10
Elapsed time (s) | Pressure (bar) | Flow rate (L/s)
-0.5292484760284424 | 0.0 | 0.0
-0.5129539966583252 | 0.0 | 0.0
-0.495891809463501 | 0.0 | 0.0
-0.4806547164916992 | 0.0 | 0.0
-0.4640312194824219 | 0.0 | 0.0
-0.4479987621307373 | 0.0 | 0.0
-0.43199920654296875 | 0.0 | 0.0
-0.41666603088378906 | 0.0 | 0.0
-0.4004709720611572 | 0.0 | 0.0
-0.3846304416656494 | 0.0 | 0.0
-0.36850571632385254 | 0.0 | 0.0
-0.35239529609680176 | 0.0 | 0.0
-0.33584141731262207 | 0.0 | 0.0
-0.3205125331878662 | 0.0 | 0.0
-0.304581880569458 | 0.0 | 0.0
-0.2892739772796631 | 0.0 | 0.0
-0.27237486839294434 | 0.0 | 0.0
-0.25576186180114746 | 0.0 | 0.0
-0.23963356018066406 | 0.0 | 0.0
-0.2246084213256836 | 0.0 | 0.0
-0.20889878273010254 | 0.0 | 0.0
-0.1925206184387207 | 0.0 | 0.0
-0.17562627792358398 | 0.0 | 0.0
-0.1601576805114746 | 0.0 | 0.0
-0.14440536499023438 | 0.0 | 0.0
-0.12798595428466797 | 0.0 | 0.0
-0.11209702491760254 | 0.0 | 0.0
-0.09679222106933594 | 0.0 | 0.0
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
