TFLVerouden/cough-machine-control/data_to_local/experiments/250324_etpof_droplets/250324_1143_ETPoF_1-8_2.csv

Experiment name | ETPoF_1-8_2
Start time (UTC) | 2025-03-24 10:43:07.670547+00:00
Opening duration (ms) | 50
Time before opening (ms) | 500
Time after closing (ms) | 1000
Ambient Temperature (Celsius) | 22.57
Relative Humidity (%) | 43.21
Elapsed time (s) | Pressure (bar) | Flow rate (L/s)
-0.5250499248504639 | 0.0 | 0.0
-0.5124008655548096 | 0.0 | 0.0
-0.4960603713989258 | 0.0 | 0.0
-0.4799211025238037 | 0.0 | 0.0
-0.46346139907836914 | 0.0 | 0.0
-0.4475259780883789 | 0.0 | 0.0
-0.43158984184265137 | 0.0 | 0.0
-0.41347837448120117 | 0.0 | 0.0
-0.4002695083618164 | 0.0 | 0.0
-0.38338422775268555 | 0.0 | 0.0
-0.36785340309143066 | 0.0 | 0.0
-0.3515503406524658 | 0.0 | 0.0
-0.33502626419067383 | 0.0 | 0.0
-0.3204371929168701 | 0.0 | 0.0
-0.3029003143310547 | 0.0 | 0.0
-0.2881450653076172 | 0.0 | 0.0
-0.27251267433166504 | 0.0 | 0.0
-0.25537991523742676 | 0.0 | 0.0
-0.23949742317199707 | 0.0 | 0.0
-0.22252678871154785 | 0.0 | 0.0
-0.20697307586669922 | 0.0 | 0.0
-0.19175982475280762 | 0.0 | 0.0
-0.1745903491973877 | 0.0 | 0.0
-0.15868330001831055 | 0.0 | 0.0
-0.14273428916931152 | 0.0 | 0.0
-0.12769436836242676 | 0.0 | 0.0
-0.11194205284118652 | 0.0 | 0.0
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
