TFLVerouden/cough-machine-control/data_to_local/experiments/250324_etpof_droplets/250324_1149_ETPoF_1-8_2.csv

Experiment name | ETPoF_1-8_2
Start time (UTC) | 2025-03-24 10:49:51.307026+00:00
Opening duration (ms) | 50
Time before opening (ms) | 500
Time after closing (ms) | 1000
Ambient Temperature (Celsius) | 22.56
Relative Humidity (%) | 43.34
Elapsed time (s) | Pressure (bar) | Flow rate (L/s)
-0.5258550643920898 | 0.0 | 0.0
-0.5124444961547852 | 0.0 | 0.0
-0.495868444442749 | 0.0 | 0.0
-0.4795405864715576 | 0.0 | 0.0
-0.46341991424560547 | 0.0 | 0.0
-0.4477231502532959 | 0.0 | 0.0
-0.43089890480041504 | 0.0 | 0.0
-0.41678309440612793 | 0.0 | 0.0
-0.39965128898620605 | 0.0 | 0.0
-0.38344526290893555 | 0.0 | 0.0
-0.3656308650970459 | 0.0 | 0.0
-0.35146021842956543 | 0.0 | 0.0
-0.3345143795013428 | 0.0 | 0.0
-0.31946492195129395 | 0.0 | 0.0
-0.30309414863586426 | 0.0 | 0.0
-0.28688716888427734 | 0.0 | 0.0
-0.2712588310241699 | 0.0 | 0.0
-0.25620031356811523 | 0.0 | 0.0
-0.23928618431091309 | 0.0 | 0.0
-0.22394251823425293 | 0.0 | 0.0
-0.20703625679016113 | 0.0 | 0.0
-0.19086837768554688 | 0.0 | 0.0
-0.17591047286987305 | 0.0 | 0.0
-0.15898418426513672 | 0.0 | 0.0
-0.14380574226379395 | 0.0 | 0.0
-0.1275646686553955 | 0.0 | 0.0
-0.1108253002166748 | 0.0 | 0.0
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
