TFLVerouden/cough-machine-control/data_to_local/experiments/050325_plasmacleanedtests/0_5ml_1percentpeo.tif

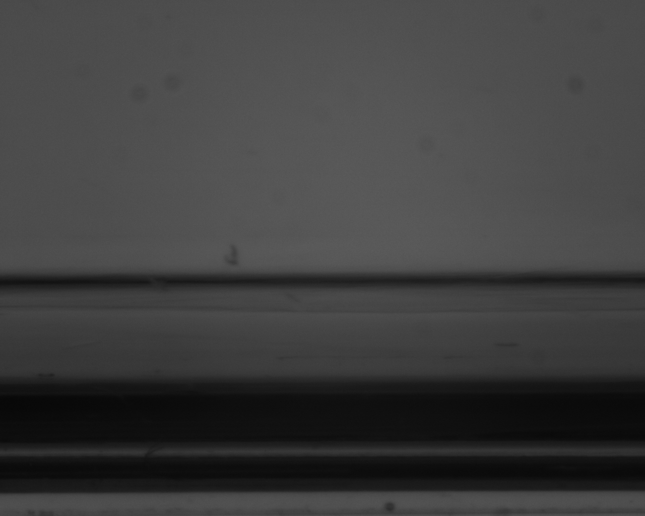
data_to_local/experiments/050325_plasmacleanedtests/0_5ml_1percentpeo.tif
