TFLVerouden/cough-machine-control/data_to_local/experiments/050325_plasmacleanedtests/1ml_0_03.tif

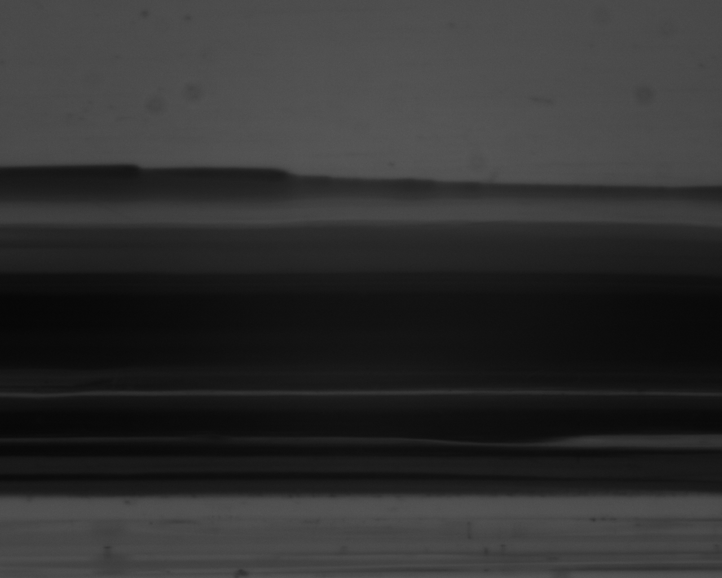
data_to_local/experiments/050325_plasmacleanedtests/1ml_0_03.tif
