TFLVerouden/cough-machine-control/data_to_local/experiments/050325_plasmacleanedtests/1ml_0_03_3rdtry.tif

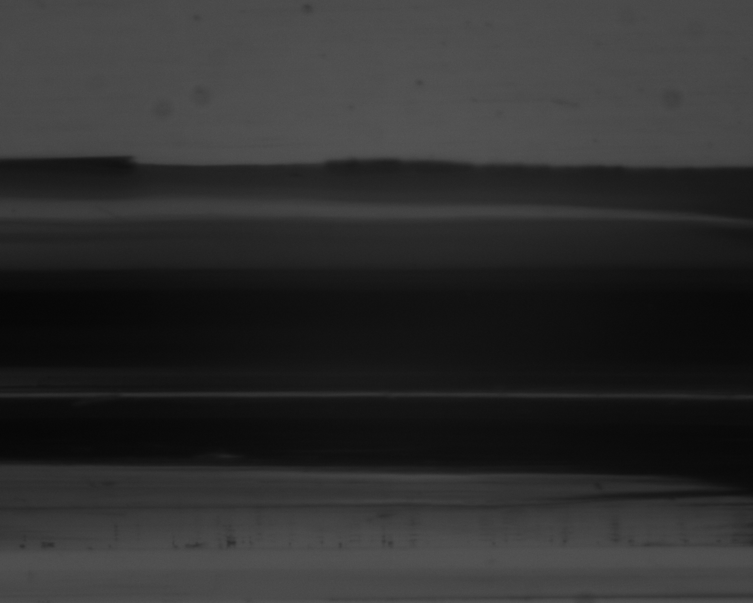
data_to_local/experiments/050325_plasmacleanedtests/1ml_0_03_3rdtry.tif
