TFLVerouden/cough-machine-control/data_to_local/experiments/050325_plasmacleanedtests/1ml_0_03_secondtry.tif

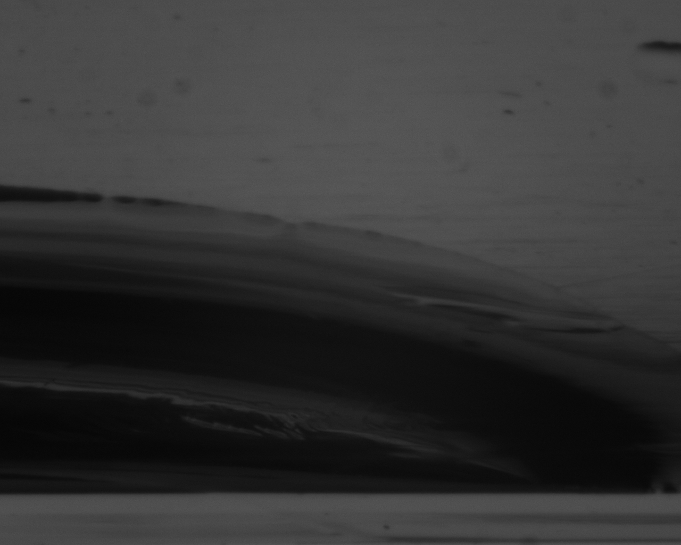
data_to_local/experiments/050325_plasmacleanedtests/1ml_0_03_secondtry.tif
