TFLVerouden/cough-machine-control/data_to_local/experiments/050325_plasmacleanedtests/060325_followup/0_5ml_peo1percent_6_3_2025.tif

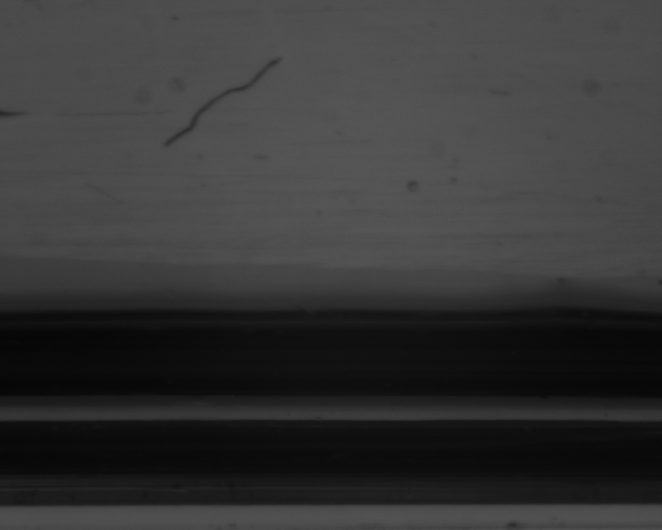
data_to_local/experiments/050325_plasmacleanedtests/060325_followup/0_5ml_peo1percent_6_3_2025.tif
