TFLVerouden/cough-machine-control/data_to_local/experiments/050325_plasmacleanedtests/250305_1435_2_5bar_50ms.png

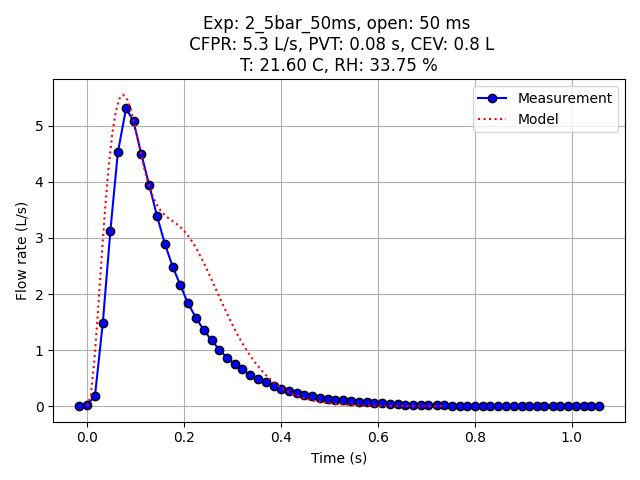
data_to_local/experiments/050325_plasmacleanedtests/250305_1435_2_5bar_50ms.png
