TFLVerouden/cough-machine-control/data_to_local/experiments/050325_plasmacleanedtests/calibration_5_3.tif

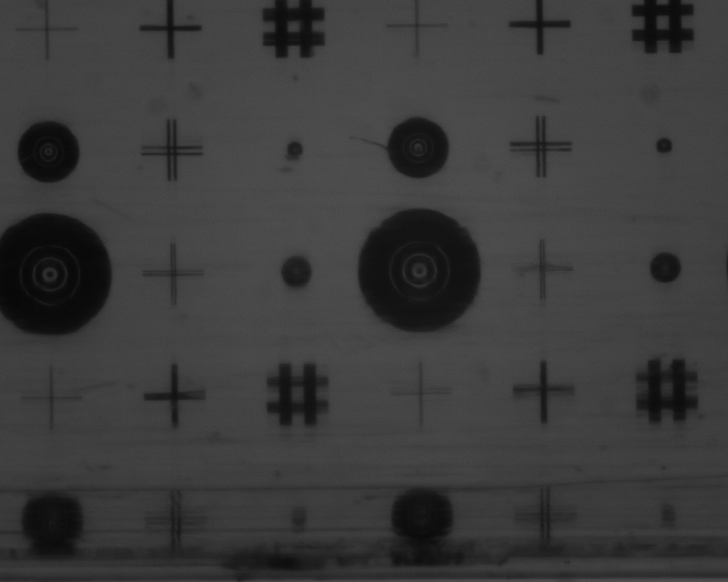
data_to_local/experiments/050325_plasmacleanedtests/calibration_5_3.tif
