TFLVerouden/cough-machine-control/data_to_local/experiments/240719_new_valve/plots/240719_new_valve.png

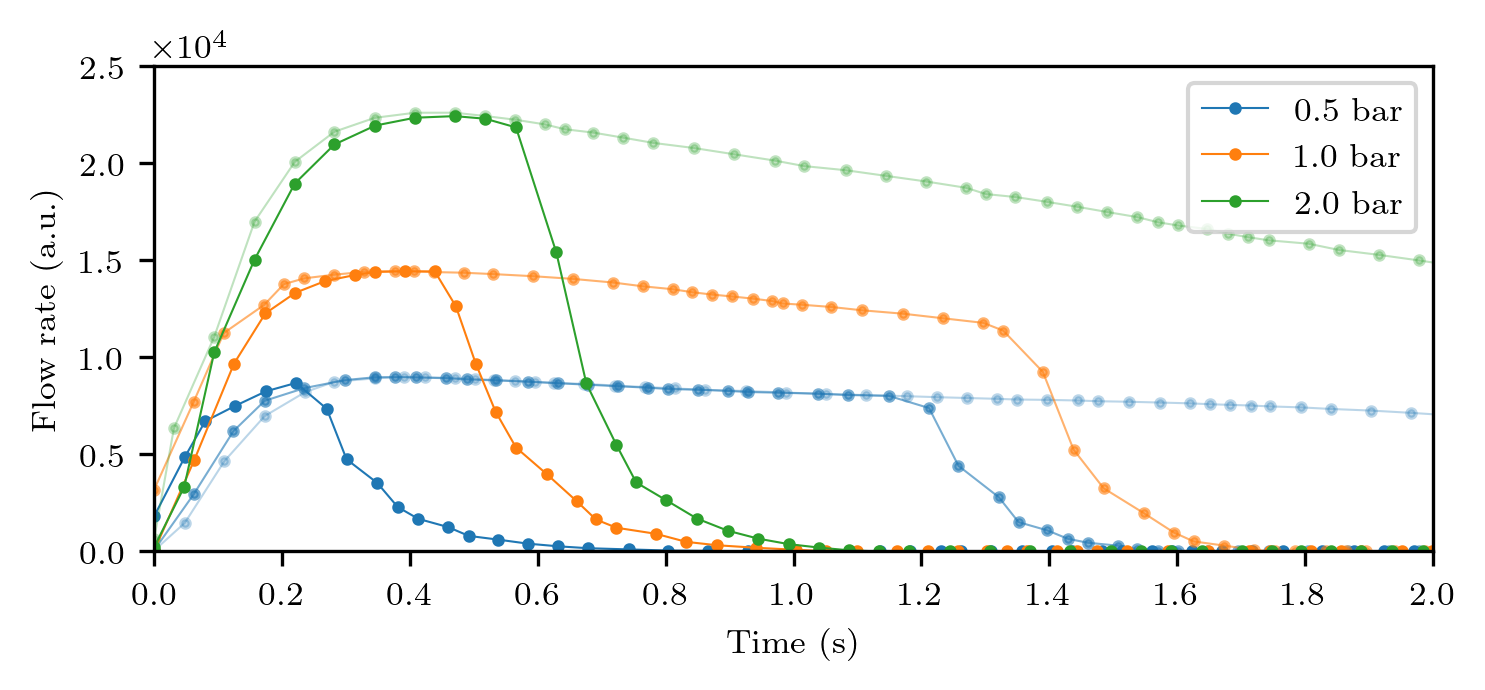
data_to_local/experiments/240719_new_valve/plots/240719_new_valve.png
