TFLVerouden/cough-machine-control/data_to_local/experiments/250324_etpof_droplets/250324_1057_ETPoF_1-32_3.png

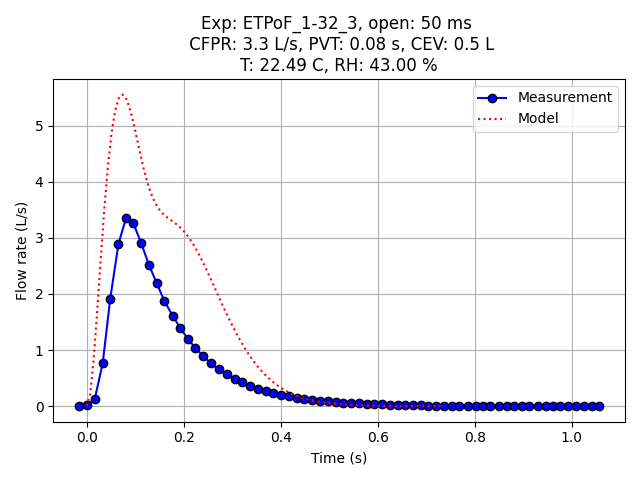
data_to_local/experiments/250324_etpof_droplets/250324_1057_ETPoF_1-32_3.png
