TFLVerouden/cough-machine-control/data_to_local/experiments/250324_etpof_droplets/250324_1143_ETPoF_1-8_2.png

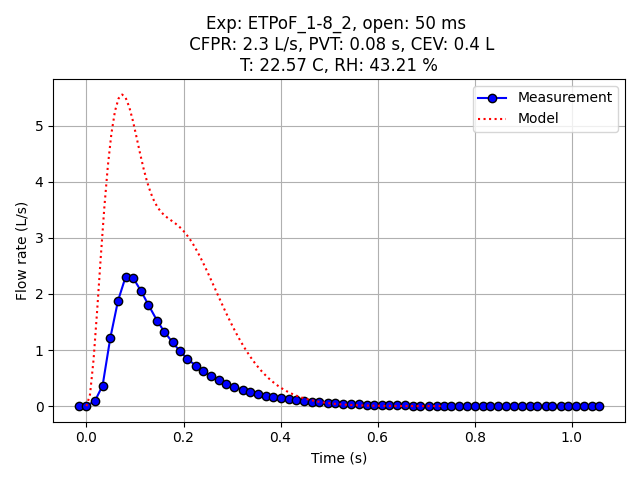
data_to_local/experiments/250324_etpof_droplets/250324_1143_ETPoF_1-8_2.png
