TFLVerouden/cough-machine-control/data_to_local/experiments/250324_etpof_droplets/250324_1208_ETPoF_1-2_1.png

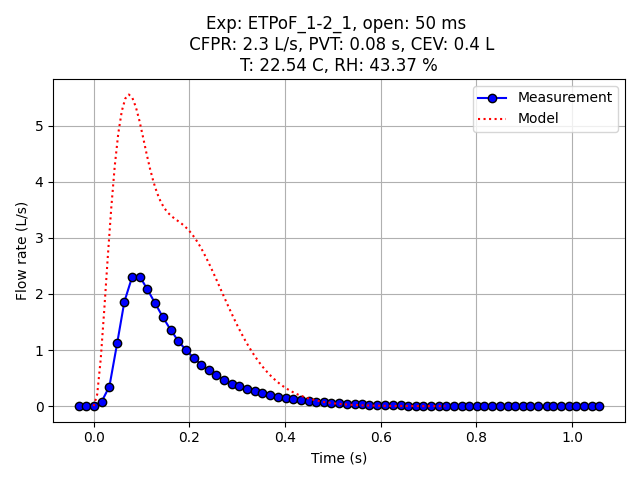
data_to_local/experiments/250324_etpof_droplets/250324_1208_ETPoF_1-2_1.png
