TFLVerouden/cough-machine-control/data_to_local/experiments/250324_etpof_droplets/250324_1230_ETPoF_1_1.png

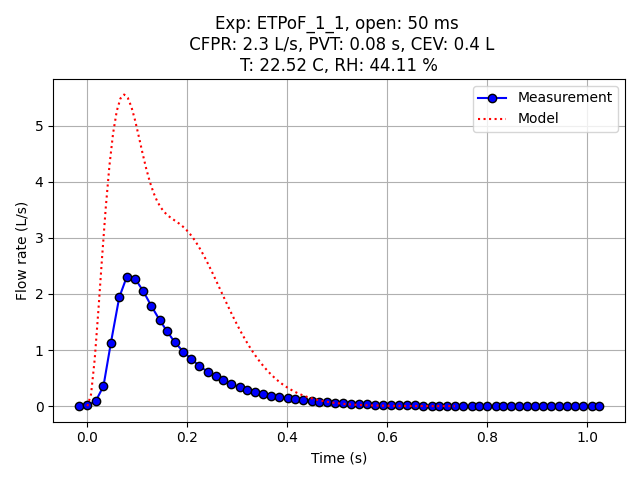
data_to_local/experiments/250324_etpof_droplets/250324_1230_ETPoF_1_1.png
