TFLVerouden/cough-machine-control/data_to_local/results_abe/2_5bar50ms.png

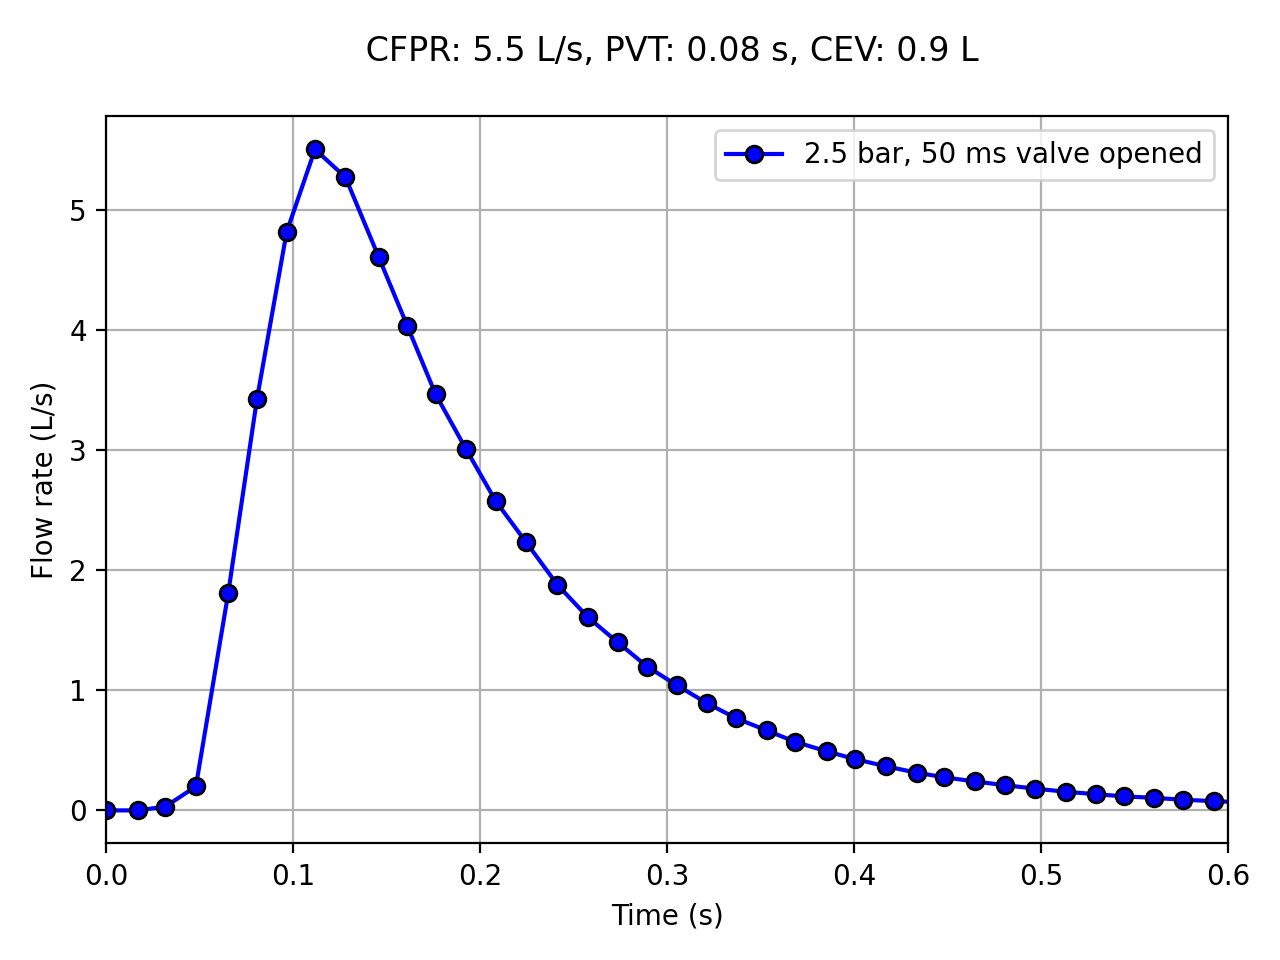
data_to_local/results_abe/2_5bar50ms.png
