TFLVerouden/cough-machine-control/data_to_local/results_abe/3bar_50ms.png

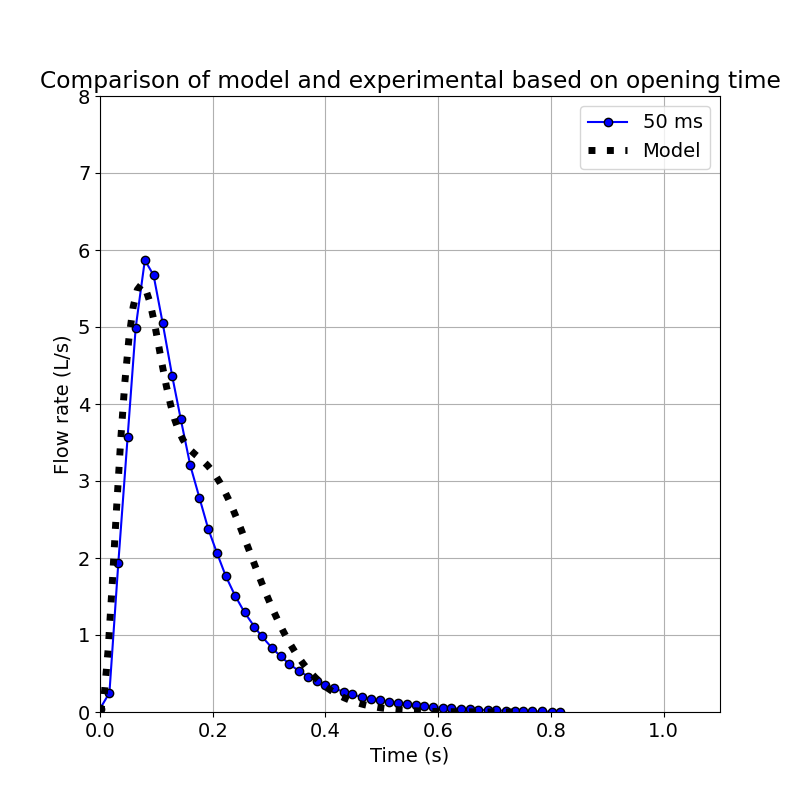
data_to_local/results_abe/3bar_50ms.png
