TFLVerouden/cough-machine-control/data_to_local/results_abe/PDF_Spraytec_0dot25.png

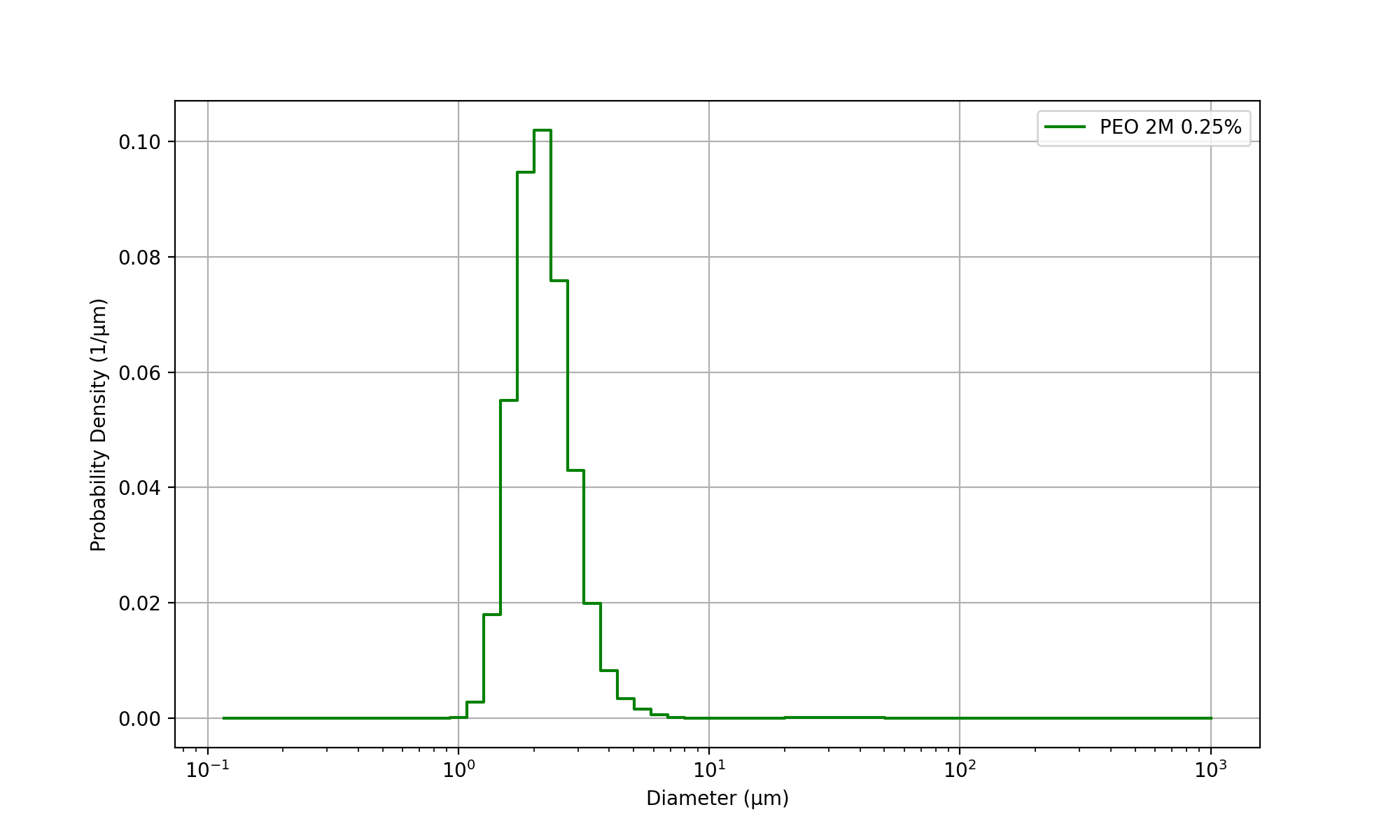
data_to_local/results_abe/PDF_Spraytec_0dot25.png
