TFLVerouden/cough-machine-control/data_to_local/results_abe/PDF_Spraytec_1.png

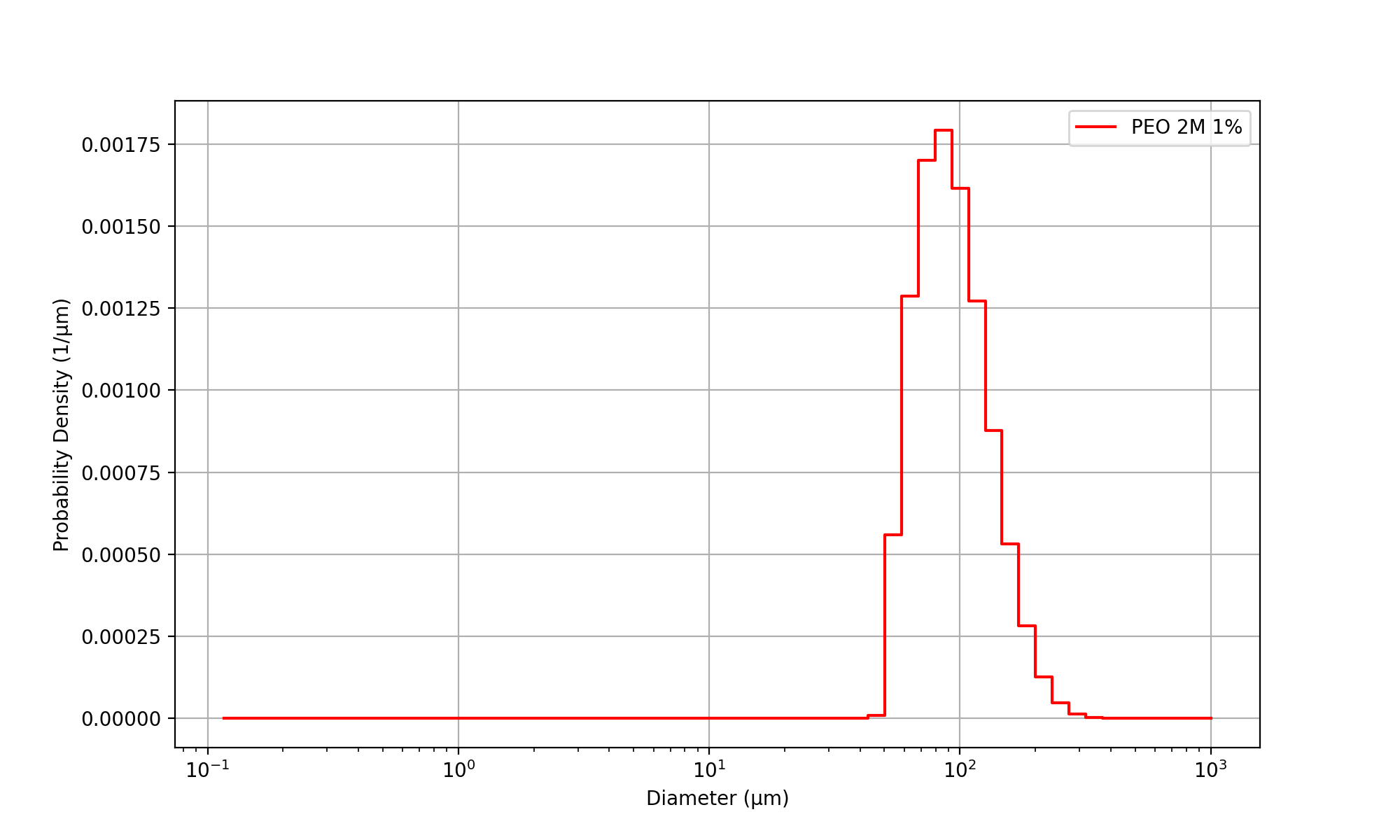
data_to_local/results_abe/PDF_Spraytec_1.png
