TFLVerouden/cough-machine-control/data_to_local/results_abe/PDF_Spraytec_alldata_percentage.png

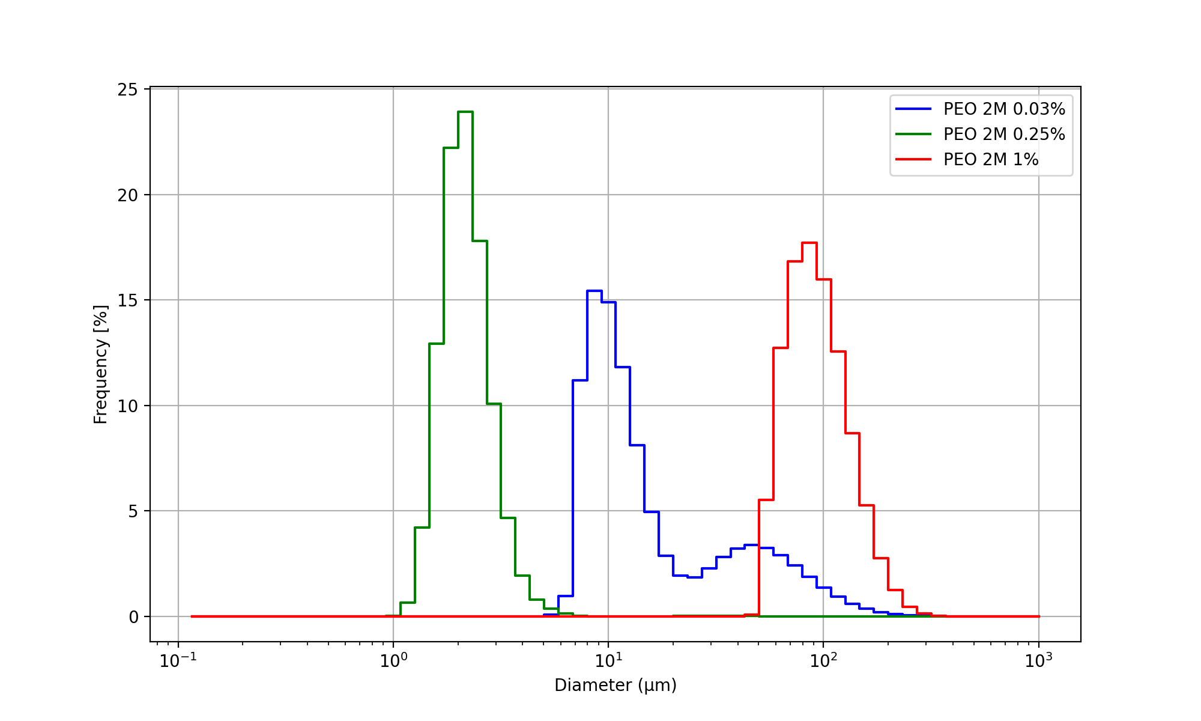
data_to_local/results_abe/PDF_Spraytec_alldata_percentage.png
