TFLVerouden/cough-machine-control/data_to_local/results_abe/PDF_Spraytec_selection_percentage.png

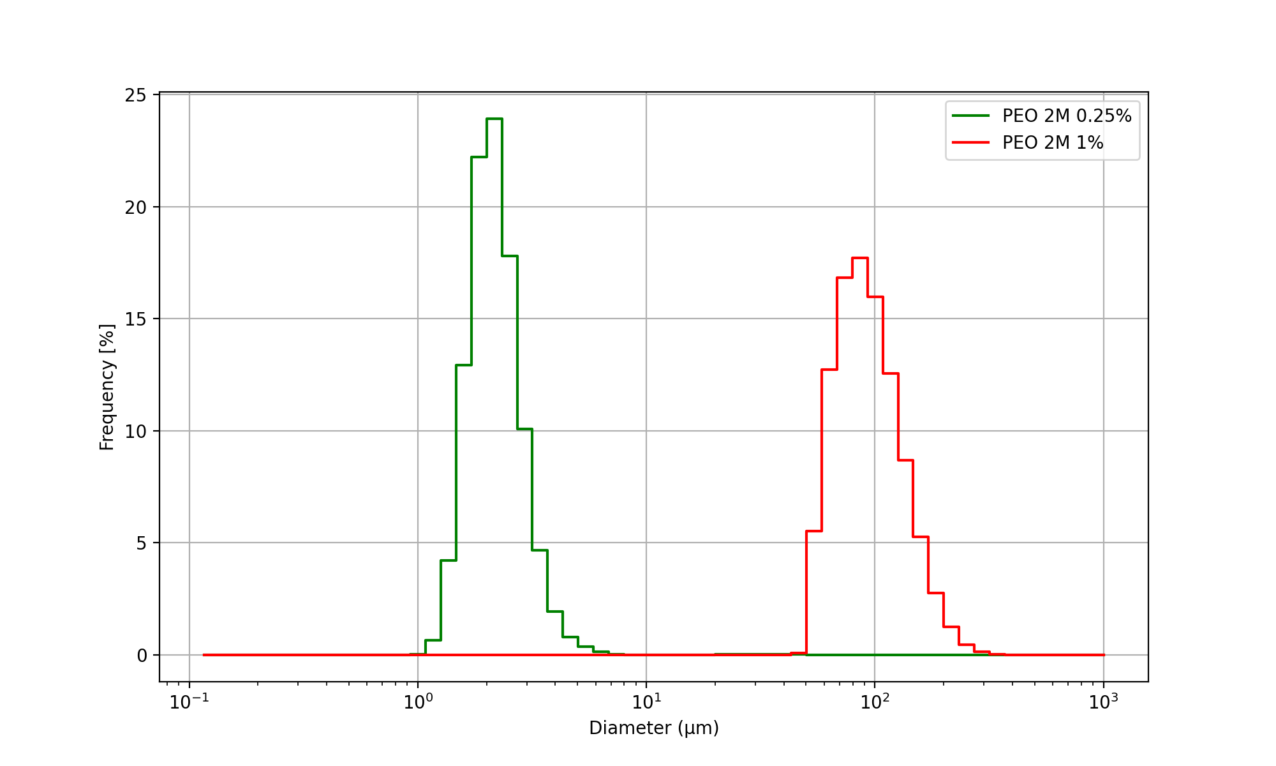
data_to_local/results_abe/PDF_Spraytec_selection_percentage.png
