TFLVerouden/cough-machine-control/data_to_local/results_abe/PDF_Spraytec_time_dependence.png

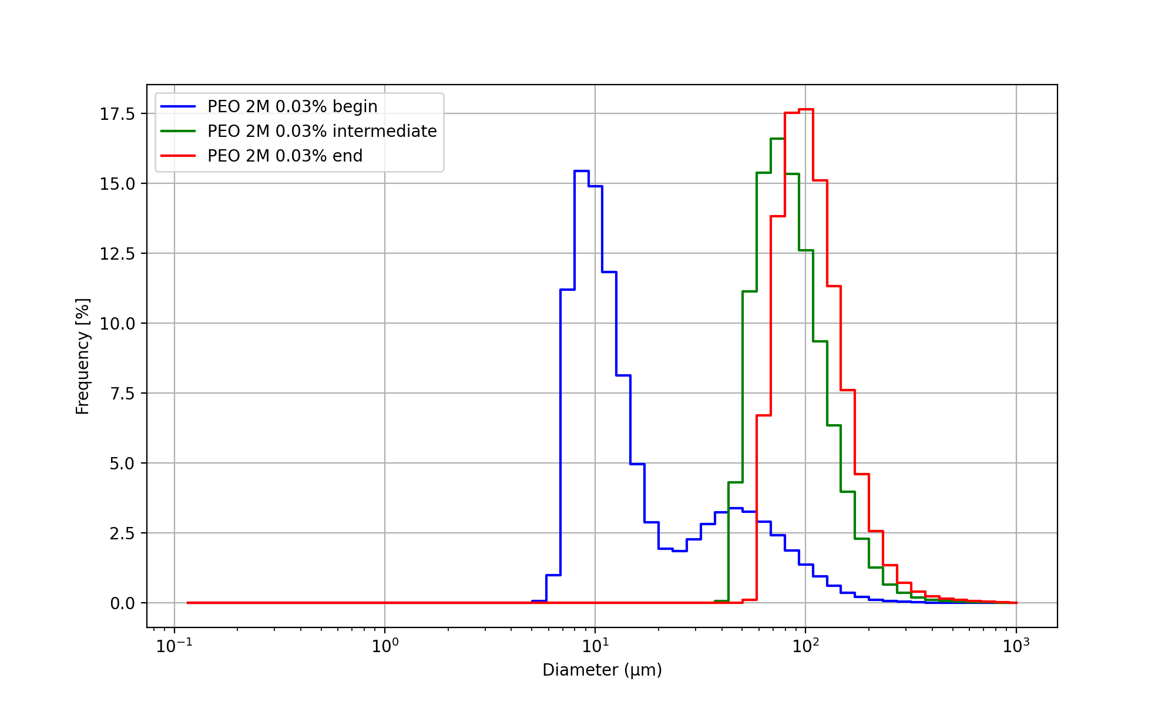
data_to_local/results_abe/PDF_Spraytec_time_dependence.png
