TFLVerouden/cough-machine-control/data_to_local/valve_control_runs_outputs_to_be_sorted/250328_1358_test.png

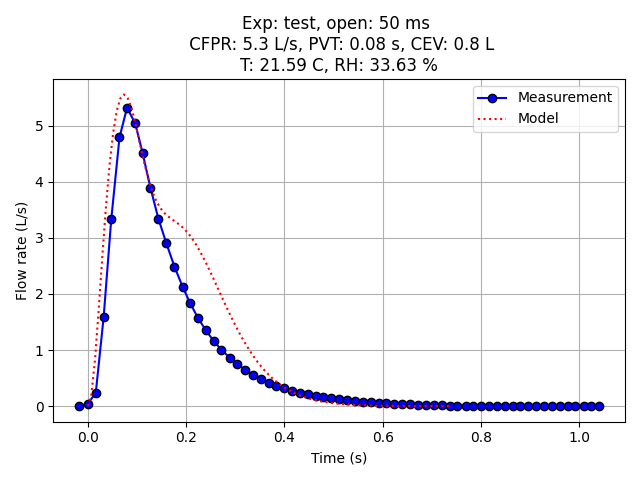
data_to_local/valve_control_runs_outputs_to_be_sorted/250328_1358_test.png
