TFLVerouden/cough-machine-control/docs/cough_machine_wiring.pdf

## Droplet detection photodiode readout

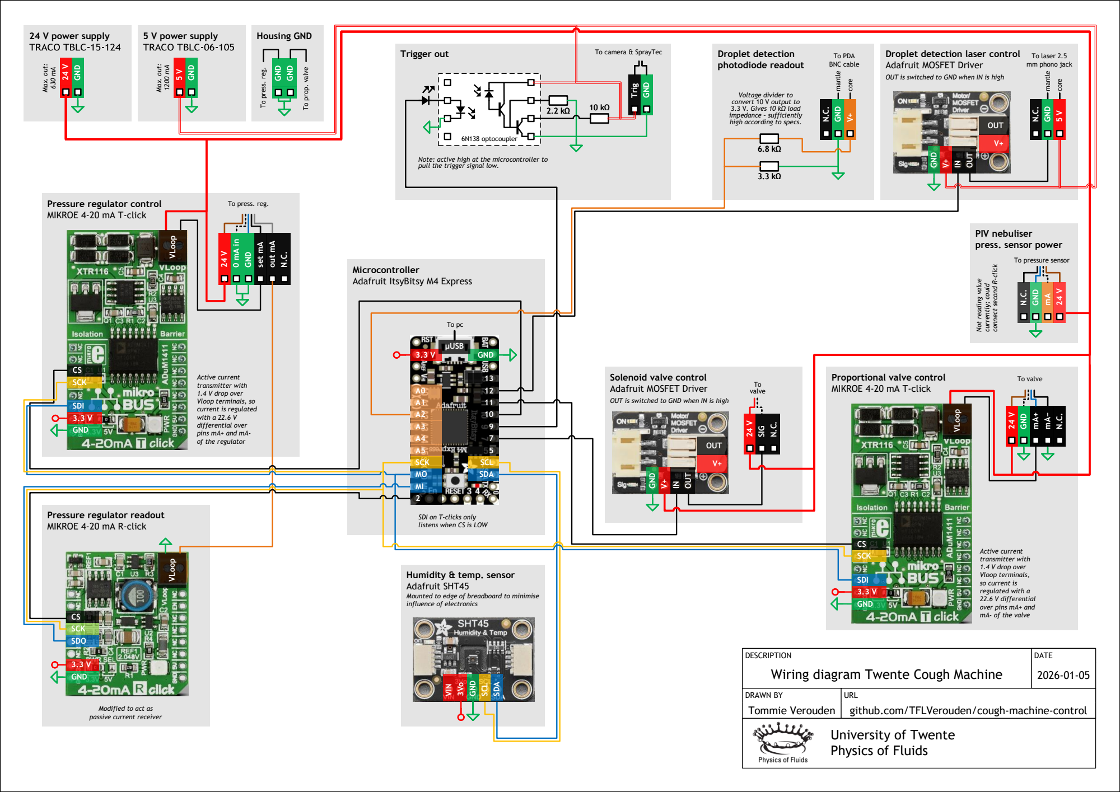
[picture p92: page 1]
OUT; GND; SDI; SCK; 5 V power supply Max. out: 1200 mA; 5 V GND; Trigger out; To camera & SprayTec; 6N138 optocoupler; Trig; 24 V power supply Max. out: 630 mA; 24 V GND; DRAWN BY; Tommie Verouden; github.com/TFLVerouden/cough-machine-control; URL; DATE; SDO; To valve; set mA; out mA; VLoop; VLoop VLoop; Housing GND GND GND To press. reg.; To prop. valve; mantle; core; To PDA BNC cable; currently; could; listens when CS is LOW VIN 3Vo GND SCL; SDA; SCL; μUSB; To valve 24 V SIG

Droplet detection laser control
Adafruit MOSFET Driver

To laser 2.5
mm phono jack

OUT is switched to GND when IN is high GND V+INOUT

Voltage divider to
convert 10 V output to
3.3 V. Gives 10 kΩ load
impedance – sufficiently
high according to specs.

Note: active high at the microcontroller to
pull the trigger signal low.

Pressure regulator control
MIKROE 4-20 mA T-click

To press. reg.

PIV nebuliser
press. sensor power

To pressure sensor

Microcontroller
Adafruit ItsyBitsy M4 Express

connect second R-click

Not reading value

Active current
transmitter with
1.4 V drop over
Vloop terminals, so
current is regulated
with a 22.6 V
differential over
pins mA+ and mA-
of the regulator

Solenoid valve control

Proportional valve control

OUT is switched to GND when IN is high

Pressure regulator readout
MIKROE 4-20 mA R-click

SDI on T-clicks only

Vloop terminals,
so current is
regulated with a
22.6 V differential
over pins mA+ and
mA- of the valve

Humidity & temp. sensor
Adafruit SHT45
Mounted to edge of breadboard to minimise
influence of electronics

DESCRIPTION
Wiring diagram Twente Cough Machine

URL
github.com/TFLVerouden/cough-machine-control
University of Twente
Physics of Fluids

Modified to act as
passive current receiver
