TFLVerouden/cough-machine-control/docs/electronics/MIKROE_4-20mA_R_click_schematic.pdf

# 4-20 mA R Click schematic v101

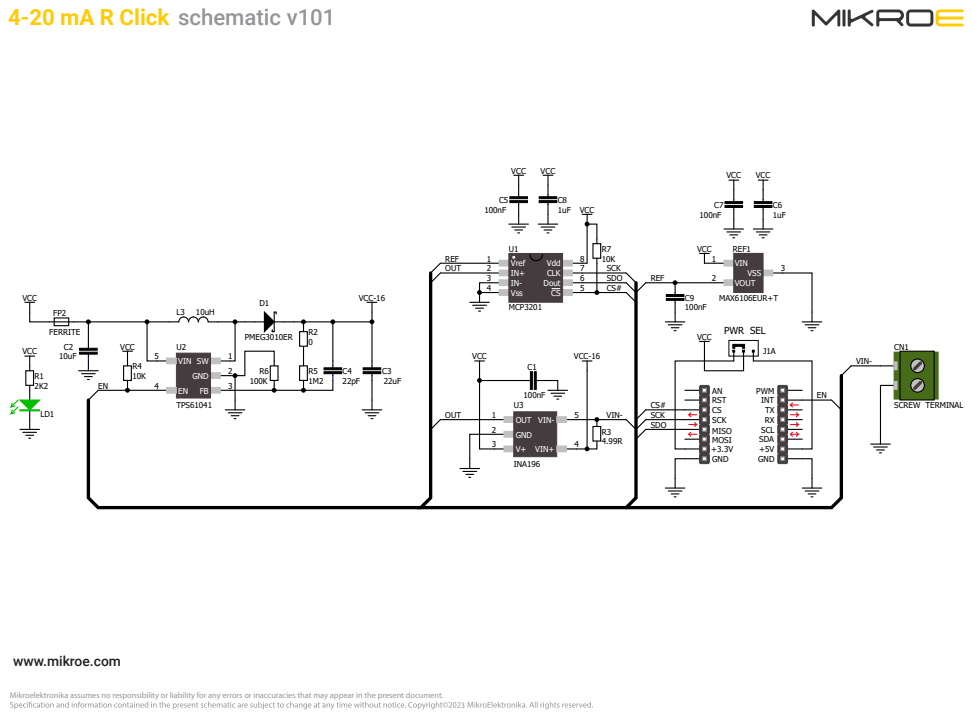
[picture p93: page 1]

Mikroelektronika assumes no responsibility or liability for any errors or inaccuracies that may appear in the present document.
