TFLVerouden/cough-machine-control/docs/electronics/MIKROE_4-20mA_T_click_schematic.pdf

# 4-20 mA T Click schematic v100

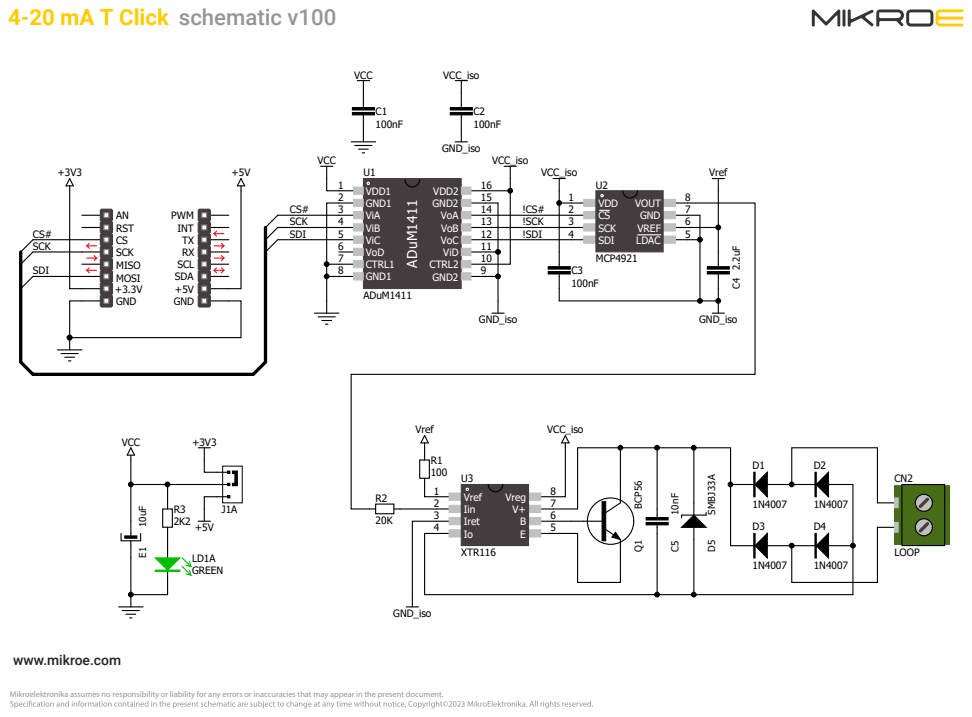
[picture p94: page 1]
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
