TFLVerouden/cough-machine-control/data_to_local/experiments/240719_new_valve/plots/new_valve.pdf

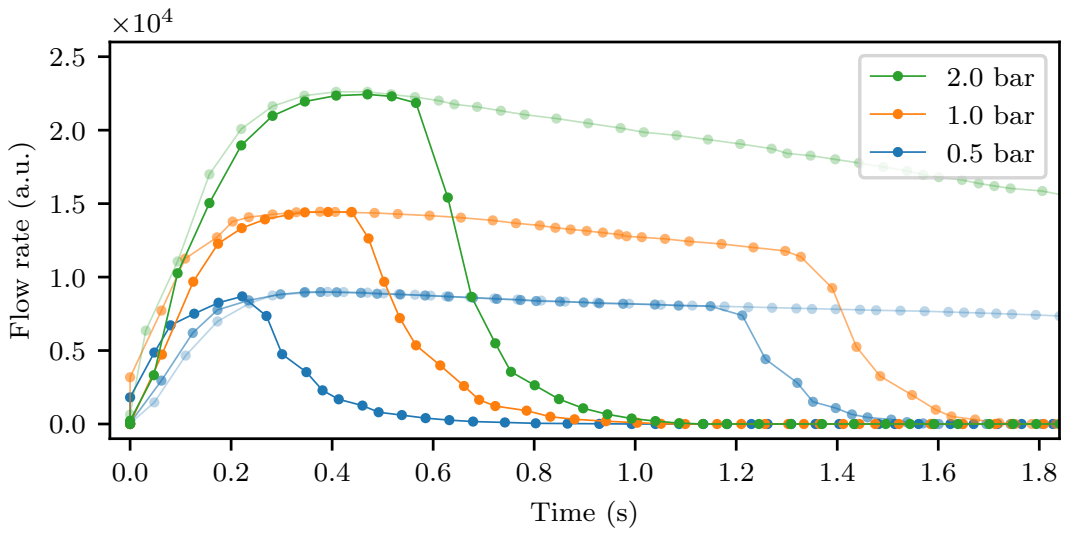
[picture p95: page 1]
Time (s); Flow rate (a.u.); 2.0 bar 1.0 bar 0.5 bar
