TFLVerouden/cough-machine-control/docs/calibration/Rclick_calibration_20251219_213025_plot.pdf

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

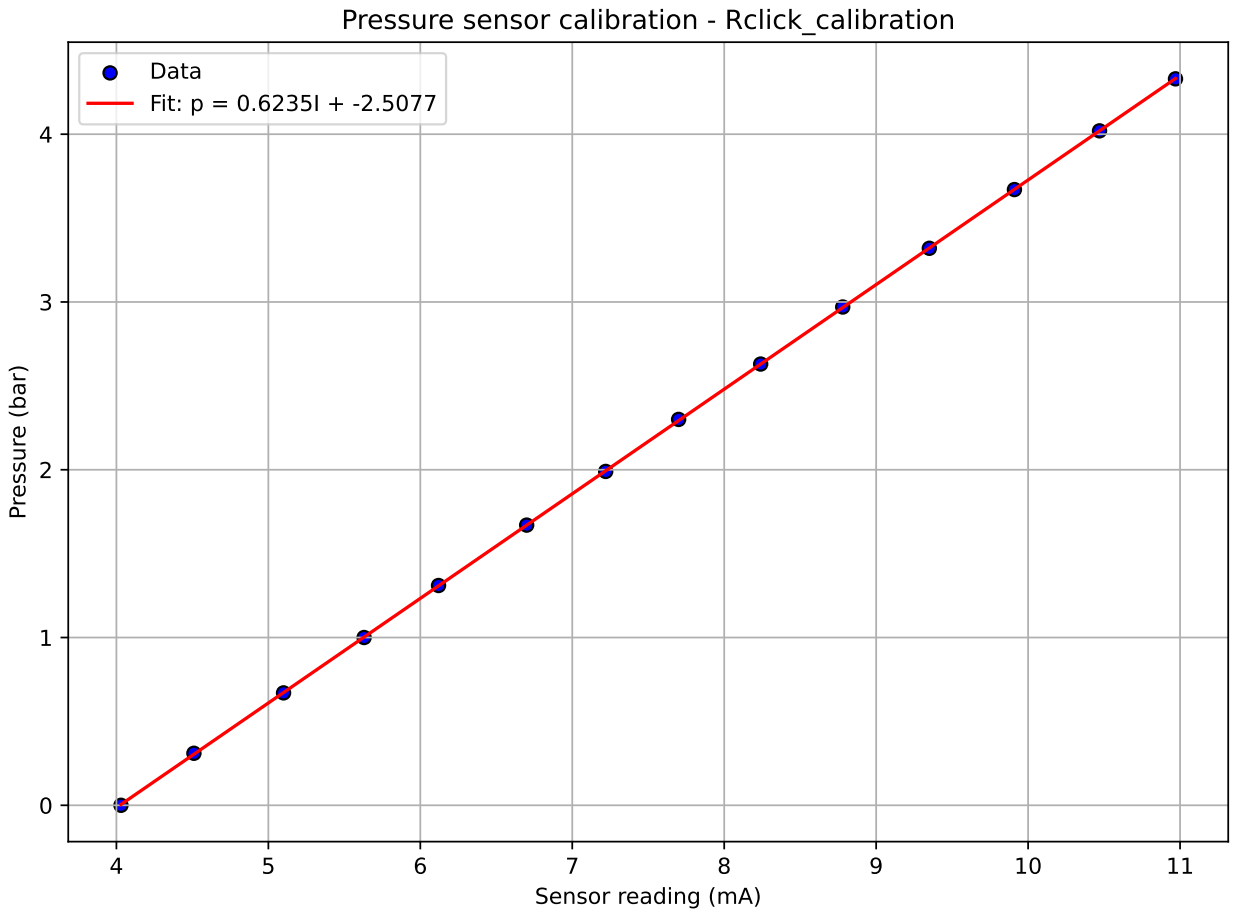
[picture p96: page 1]
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
