TFLVerouden/cough-machine-control/docs/electronics/StarTech_ICUSB2324I_diagram.pdf

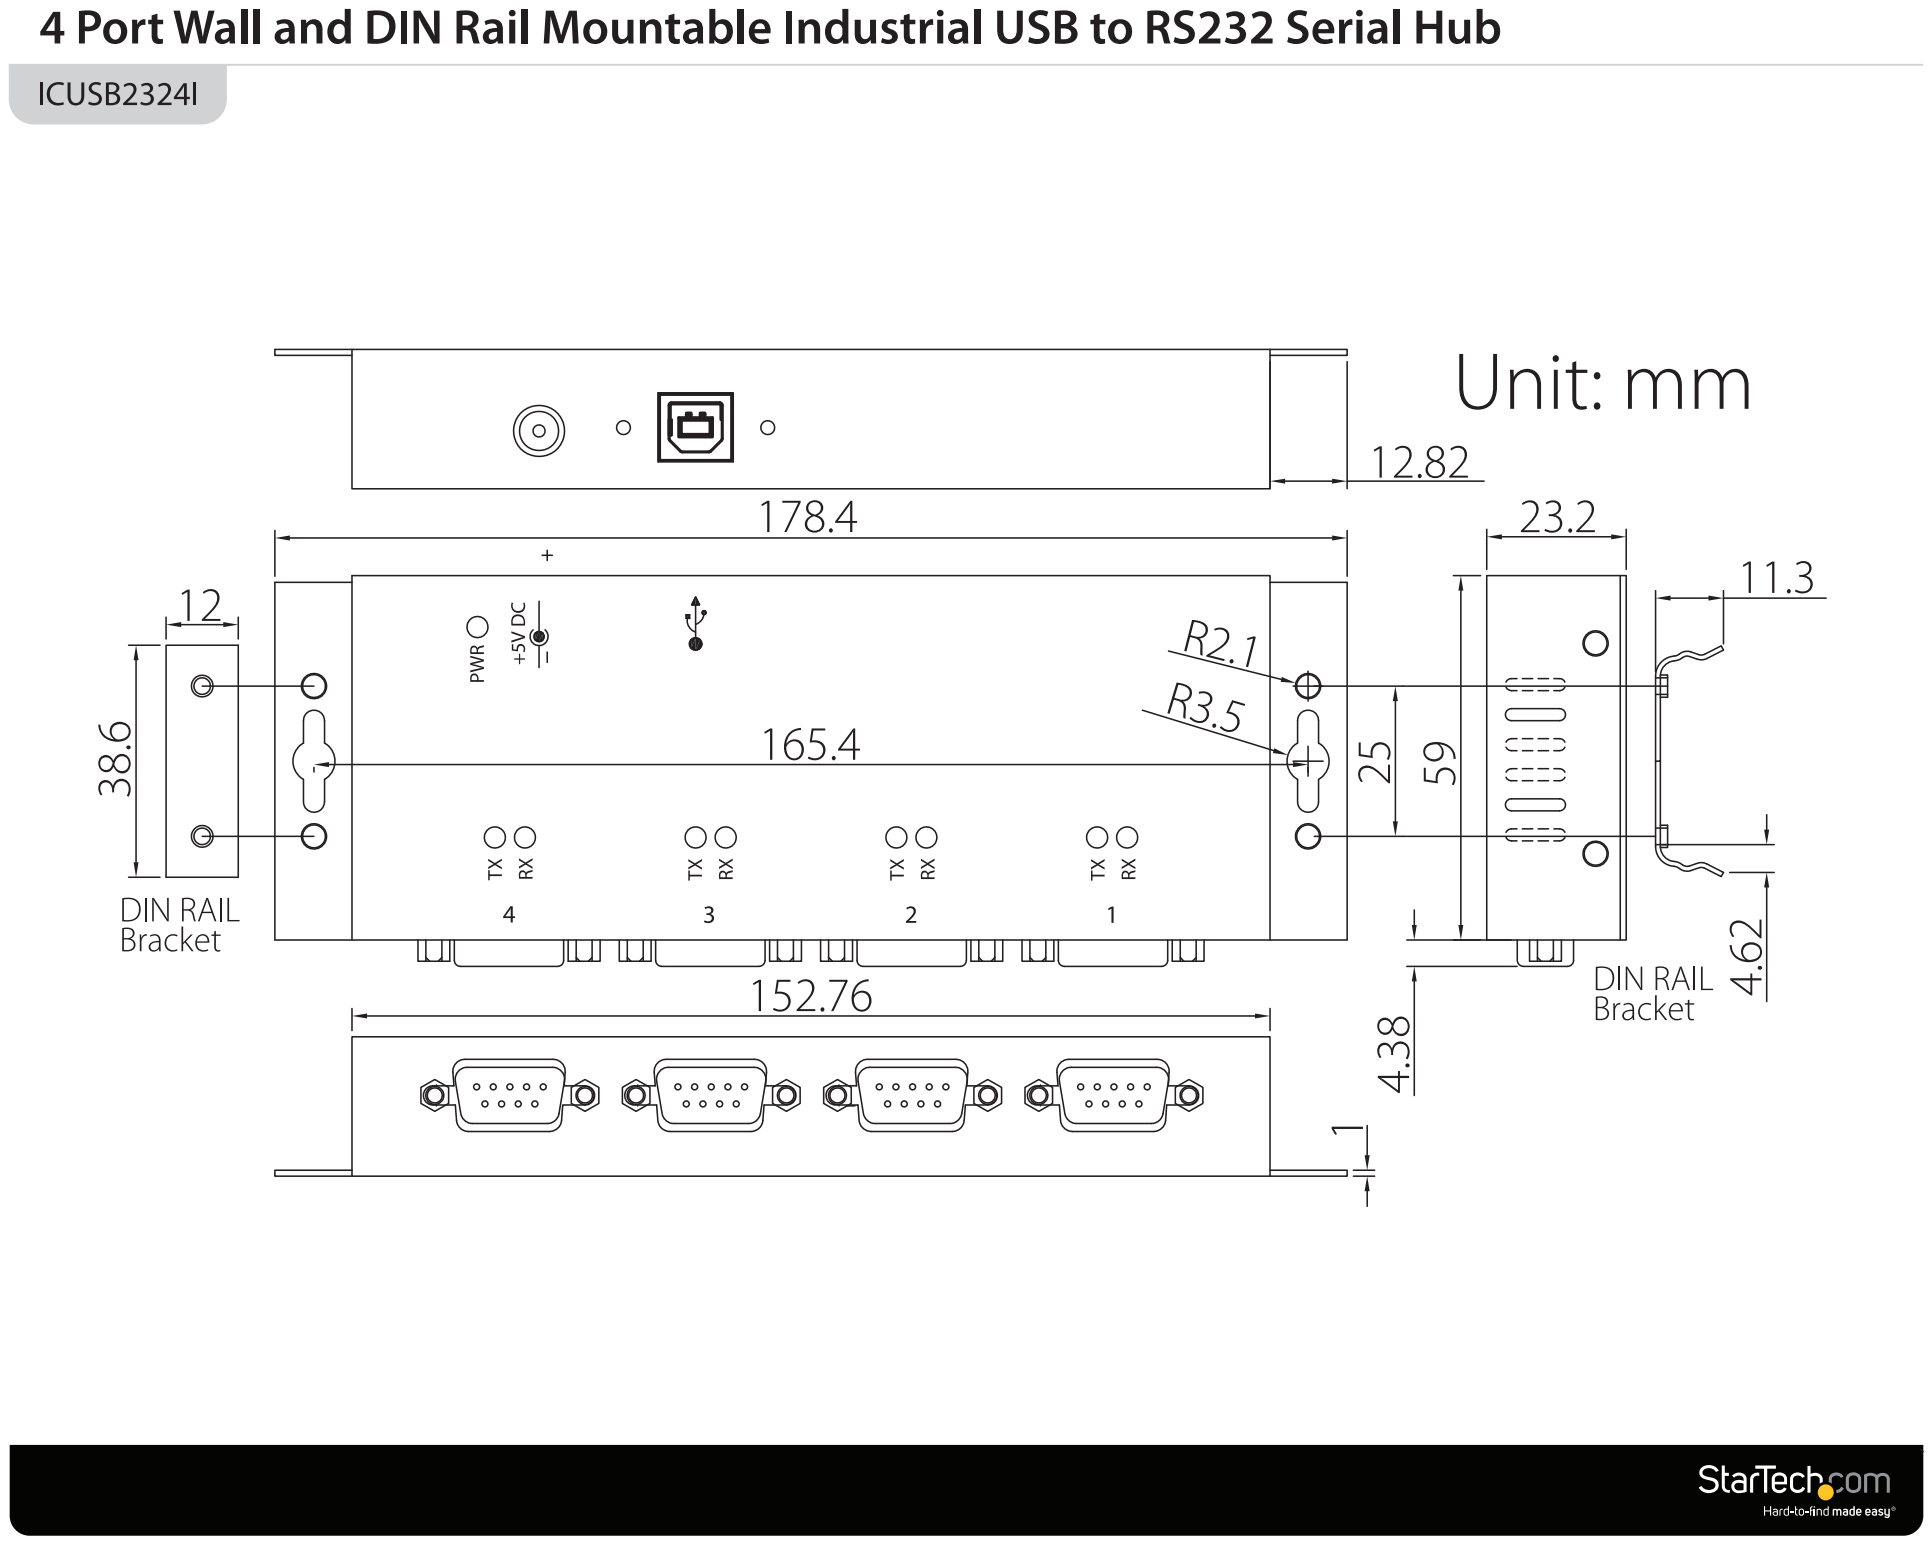
[picture p97: page 1]
