TFLVerouden/cough-machine-control/docs/peripherals/pump_cable/Assmann_AT-S-26-6-6-S-7_RJ12_straight_through_cable.pdf

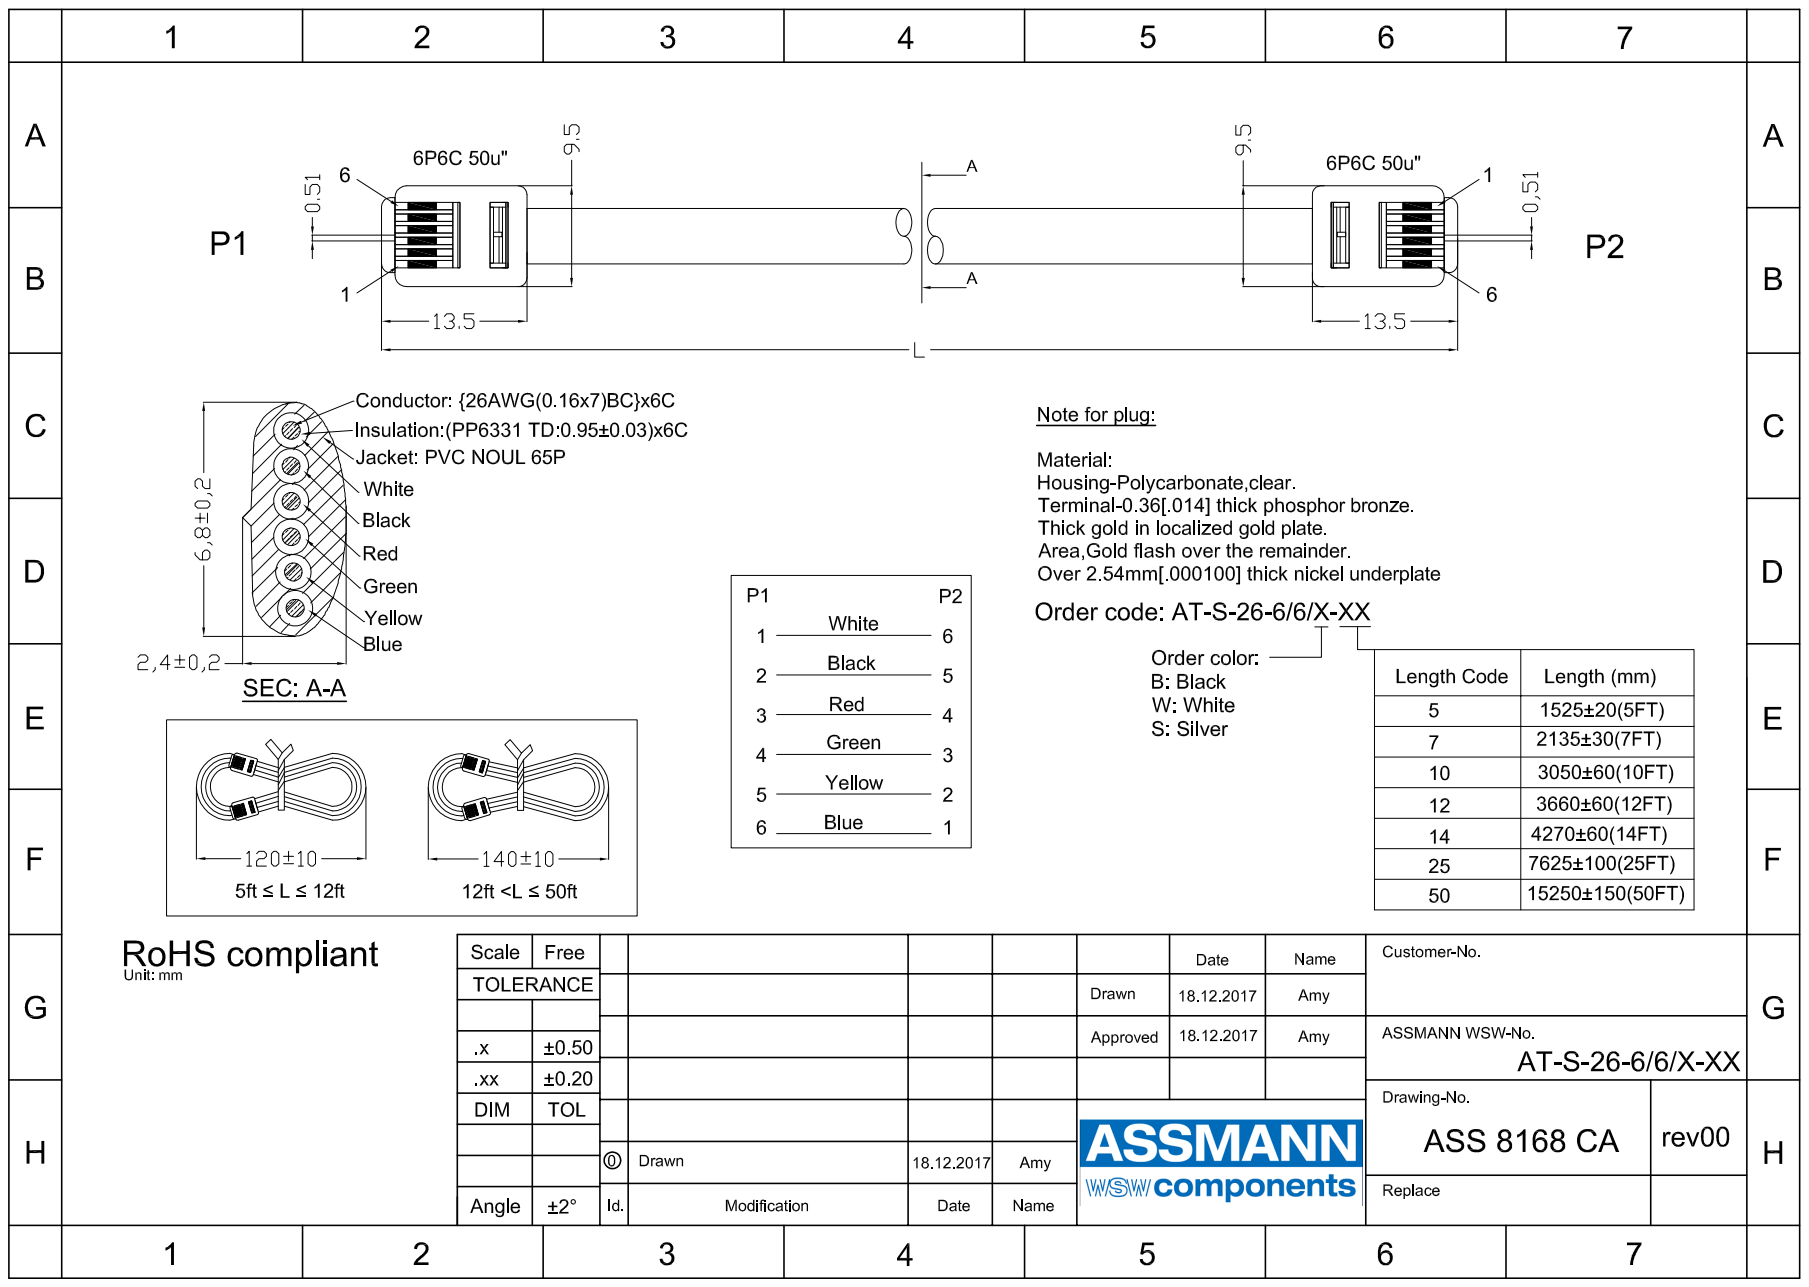
[picture p98: page 1]
