TFLVerouden/cough-machine-control/data_to_local/piv/processed/PIV250723/PIV_1bar_80ms_closedtank/pass3_v-t_med.pdf

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

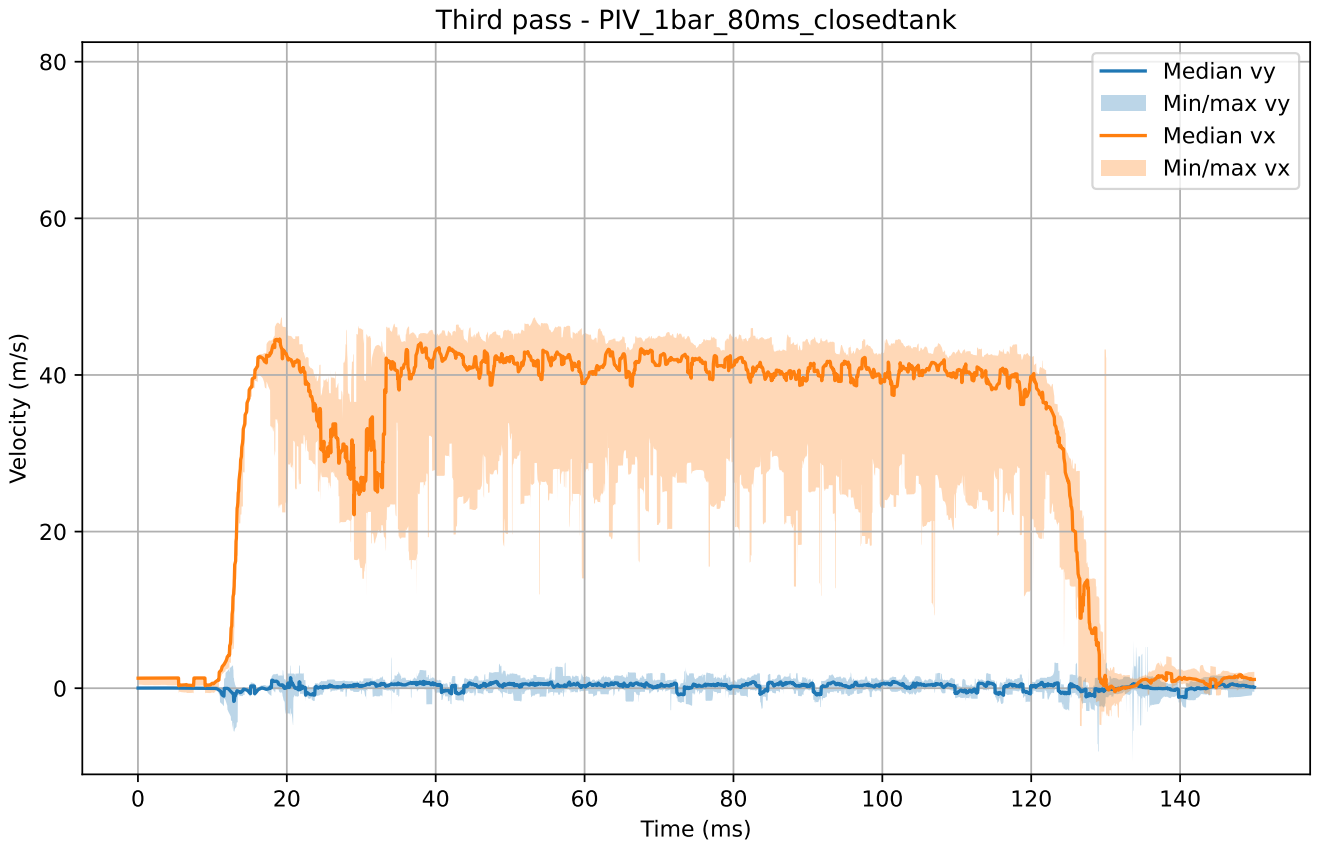
[picture p102: page 1]
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
