TFLVerouden/cough-machine-control/data_to_local/piv/processed/PIV250723/PIV_1dot5bar_80ms_refill/pass2_v_prof_median.pdf

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

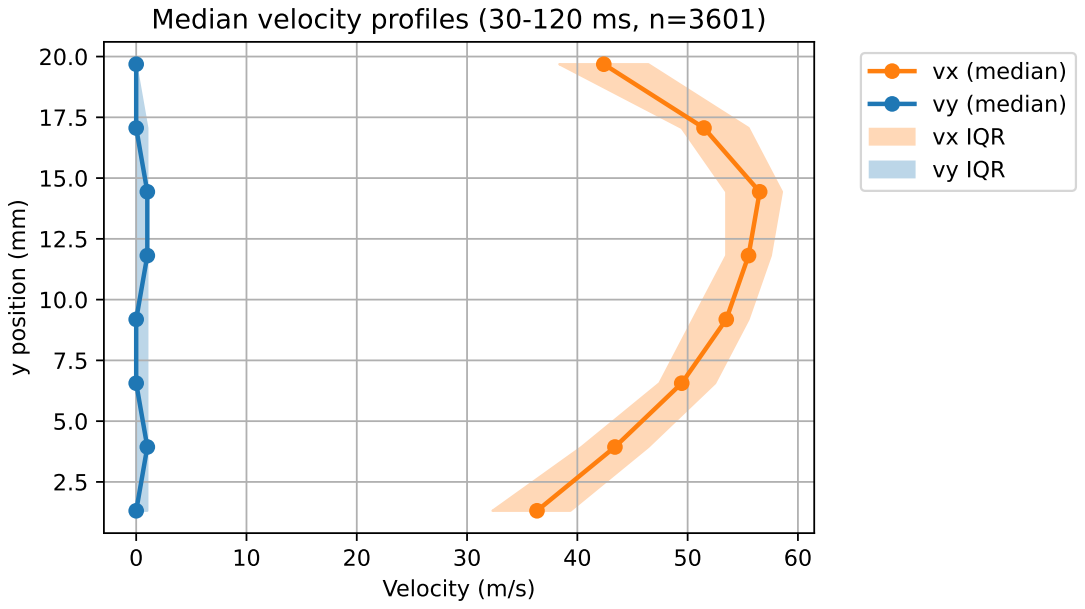
[picture p117: page 1]
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
