TFLVerouden/cough-machine-control/data_to_local/piv/processed/PIV250624/250624_1338_80ms_nozzlepress1bar/pass2_v_med.pdf

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

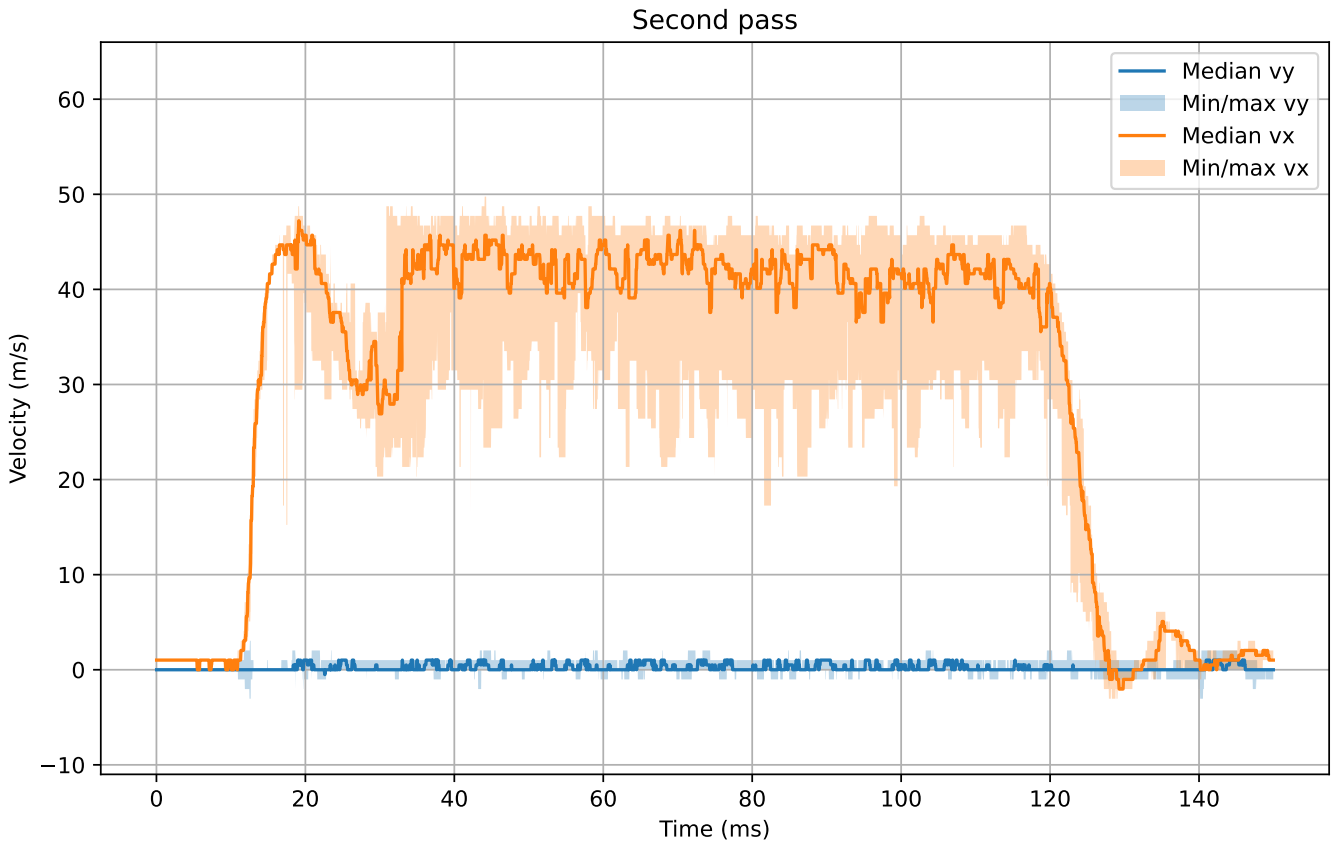
[picture p131: page 1]
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
