TFLVerouden/cough-machine-control/data_to_local/piv/processed/PIV250624/250623_1608_secondtest/pass1_v-t.pdf

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

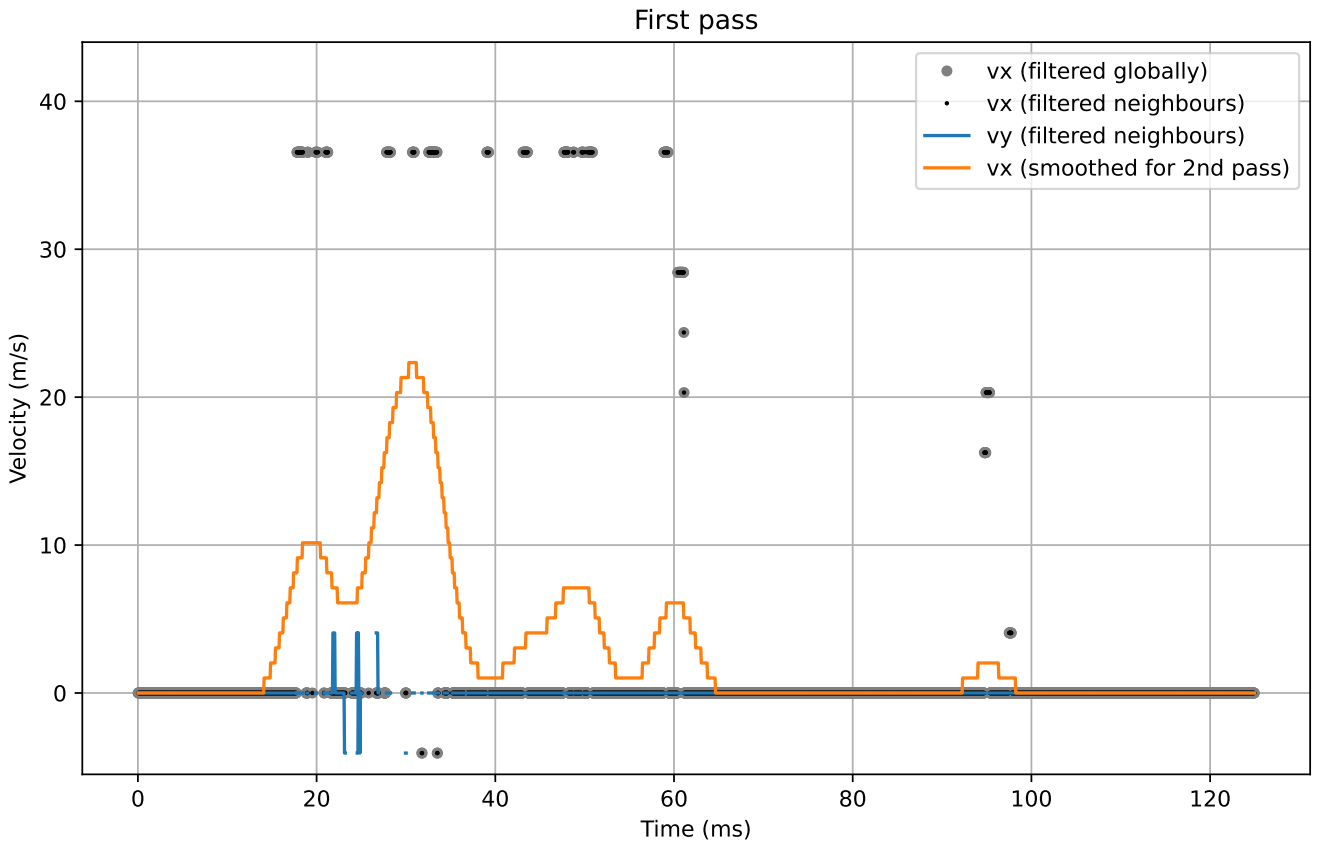
[picture p133: page 1]
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
