TFLVerouden/cough-machine-control/valve_control/arduino_tests/test_pressure_readout/test_pressure_readout.ino

#include <Arduino.h>
#include "MIKROE_4_20mA_RT_Click.h"

// The cable select pin of the R Click
const uint8_t PIN_R_CLICK = 10;

// Exponential moving average (EMA) parameters of the R Click readings
const uint32_t EMA_INTERVAL = 500; // Desired oversampling interval [µs]
const float EMA_LP_FREQ = 200.;      // Low-pass filter cut-off frequency [Hz]

// Adjust the calibration parameters as needed
R_Click R_click(PIN_R_CLICK, RT_Click_Calibration{3.99, 9.75, 795, 1943});

void setup() {
  Serial.begin(9600);
  R_click.begin();
}

void loop() {
  uint32_t now = millis();
  static uint32_t tick = now;

  R_click.poll_EMA();

  // Report readings over serial every 0.1 sec
  if (now - tick > 1000) {
    tick = now;
    Serial.println(0.6249*R_click.get_EMA_mA() - 2.4882);
  }
}
