TFLVerouden/cough-machine-control/(commit log)

2024-08-20 Made a plot of the flow rate of the quick new valve tests
2025-01-07 Python communication with Arduino; and Arduino sketch to make the LED turn on, on command for a set amount of time
2025-01-07 Generalisation of functions; can specifiy baud rate and device name
2025-01-13 Adapted to new Arduino type; added close function
2025-01-20 Added port choice menu; started flow meter connection
2025-01-24 Added old flow meter controls
2025-01-27 Simplified duration entry, added stub pressure command
2025-01-27 Fix Arduino file structure
    [valve_control.ino]
2025-01-27 Fixed old flow meter readout
2025-01-27 Valve control while loop stub
2025-01-27 Cleaned up file structure
    [250127_1221_test.csv]
2025-02-03 Fixed not finishing after valve is closed; added basic flow meter readout
    [250127_1221_test.csv, 250203_1116_test.csv]
2025-02-03 Added flow meter settings screenshot from FlowTune
2025-02-03 Adapted baud rate; new tests
    [250203_1137_test.csv, 250203_1220_test.csv]
2025-02-03 Convertion of flow_meter_calibration_value
2025-02-03 Changed flow rate to L/s. Changed reading to numpy instead of list appending
    [250203_1116_test.csv, 250203_1137_test.csv, 250203_1220_test.csv, 250203_1518_test.csv]
2025-02-03 Added code to automatically generate plots of the flow with its characteristic numbers. Including some preliminary plots
    [250203_1518_test.csv, 250203_1635_200ms_1bar.csv, 250203_1636_200ms_1bar.csv, 250203_1637_1.5bar_200ms.csv, 250203_1648_2bar_60ms.csv, 250203_1648_2bar_80ms.csv, 250203_1649_2bar_100ms.csv, 250203_1650_1.75bar_100ms.csv]
2025-02-03 some more data
    [250203_1705_3bar_60ms.csv, 250203_1705_3bar_80ms.csv, 250203_1727_1bar_400ms.csv]
2025-02-04 Added code (ModelGuptavsExp.py) to process first experimental data and compare it to model.
    [250203_1635_200ms_1bar.csv, 250203_1636_200ms_1bar.csv, 250203_1637_1.5bar_200ms.csv, 250203_1648_2bar_60ms.csv, 250203_1648_2bar_80ms.csv, 250203_1649_2bar_100ms.csv, 250203_1650_1.75bar_100ms.csv, 250203_1650_1.75bar_60ms.csv]
2025-02-04 Code to analyse shorter opening times
    [250203_1635_1bar_200ms.csv, 250203_1636_1bar_200ms.csv]
2025-02-05 added option to save the test, and picture of flow speed from Bronkhorst Software
2025-02-05 mimicking reading the Flow Sensor
2025-02-06 First try at writing code, which a. uses t0 as the moment, where the valve opens. b. is capable of enabling a second cough
2025-02-06 Create valve_duo_control.py
    Second cough modeling:
    First try at writing code, which a. uses t0 as the moment, where the valve opens. b. is capable of enabling a second cough
2025-02-06 some data and experiments with dual coughs. To check if it is feasible, and test sensor
    [250206_1329_3bar_all300ms.csv, 250206_1331_100_50_10.csv, 250206_1331_100_50_50_3bar.csv, 250206_1333_100_100_10.csv, 250206_1334_200_200_200_2bar.csv]
2025-02-07 Integrated the Temperature and Humidity sensor into the circuit. Changed t0 to moment where valve opens
    [250207_1428_T_RHintegration.csv]
2025-02-11 Gave an option to directly plot model into flow measurements. added60ms_80ms png.
2025-02-11 Some cough_pattern_tests with fast opening times
    [250211_1213_2bar_60ms.csv, 250211_1214_2.5bar_60ms.csv, 250211_1215_2.5bar_55ms.csv, 250211_1220_3bar_50ms.csv, 250211_1221_3bar_45ms.csv, 250211_1225_3.2bar_45ms.csv, 250211_1228_3.4bar_45ms.csv, 250211_1229_3.5bar_45ms.csv]
2025-02-21 Data of 21-2, first preliminary tests
    [250221_1321_first_test.csv]
2025-02-21 Mainly changes to GUI stuff
    [250206_1329_3bar_all300ms.csv, 250206_1331_100_50_10.csv, 250206_1331_100_50_50_3bar.csv, 250206_1333_100_100_10.csv, 250206_1334_200_200_200_2bar.csv, 250207_1428_T_RHintegration.csv]
2025-02-26 Cough flow 26feb
    [250226_1656_2.5bar_expconditions.csv]
2025-02-27 Now only when asked to save data it will ask further questions, furthermore added a ready button
2025-02-27 Added pressure_readout test; added wiring diagram; moved some ino test files
2025-03-04 Navitar lens fluid thickness files
2025-03-05 Added delay in ready to cough. Experimental data of 05-03-2025
    [250305_1435_2_5bar_50ms.csv]
2025-03-06 Pump integration stub
2025-03-07 Cleaned up Ximea and valve control
    Cleaned up Ximea files, and valvecontrol files
    [250203_1635_200ms_1bar.csv, 250203_1636_200ms_1bar.csv, 250203_1637_1.5bar_200ms.csv, 250203_1648_2bar_60ms.csv, 250203_1648_2bar_80ms.csv, 250203_1649_2bar_100ms.csv, 250203_1650_1.75bar_100ms.csv, 250203_1650_1.75bar_60ms.csv]
2025-03-07 Continue debugging pump code
2025-03-07 Integrated Ximea into valve control
    Now the Ximea should be integrated in the valve control code, the optimization of exposure time is still in process.
    Added try-except blocks if not found.
    Added option to properly save the data to desired directories.
2025-03-14 Tried DvG 4-20 mA readout code; something wrong because outputs nans
    [test_pressure_readout.ino]
2025-03-25 2.5bar measurement csv to link to video.
    [250324_1633_test.csv]
2025-04-01 ETPoF kids droplet atomisation curves
    [250324_1028_ETPoF_1-32_1.csv, 250324_1048_ETPoF_1-32_2.csv, 250324_1057_ETPoF_1-32_3.csv, 250324_1137_ETPoF_1-8_1.csv, 250324_1143_ETPoF_1-8_2.csv, 250324_1149_ETPoF_1-8_2.csv, 250324_1152_ETPoF_1-8_3.csv, 250324_1208_ETPoF_1-2_1.csv]
2025-04-01 Added camera trigger and updated pressure readout
2025-04-02 Plotting flowmeter curve
    [2_5bar50ms.csv]
2025-05-15 Tank pressure sensor calibration, readout & processing
2025-05-15 Old test; might be fine to delete
    [250324_1603_test.csv, 250328_1356_test.csv, 250328_1357_test.csv, 250328_1358_test.csv, 250417_1342_test.csv]
2025-05-15 Added pressure & lift readout to plot
    [250515_1322_emptythetank.csv]
2025-05-20 Trying to talk to the pump
2025-06-16 Fixed the bug where it stopped from the pressure readout
    [valve_control.ino]
2025-06-16 Now it gives an error if no flow rate data is found and you still want to save the data
2025-06-24 PIV cough machine data saved
    [250623_1141_PIV1.csv, 250623_1608_PIV2.csv, 250624_1115_PIV3.csv, 250624_1134_PIV4.csv, 250624_1143_PIV5.csv, 250624_1212_PIV6.csv, 250624_1323_PIV7.csv, 250624_1331_PIV8.csv]
2025-06-24 Calibration opening 12bit file
2025-06-25 Subpixel accuracy calibration from grid
2025-06-26 PIV cough machine lower pressure tests
    [250626_1431_PIV10.csv, 250626_1444_PIV11.csv]
2025-06-30 Code for 1st pass ((full frame) complete, incl. downsampling & multi-peak detection; tested on 1 full video. Subpixel implemented for 2nd pass
2025-07-02 OS-independent file handling for piv too (Abe pls test!); cleaned up calibration
2025-07-04 Missing factor 2 in calibration......
2025-07-04 topview measurement
    [250704_1610_0dot75bar1percent_topview.csv]
2025-07-07 Restructured outlier detection functions; intensity filtering
2025-07-09 Droplet detection first tests Arduino code + got the RGB LED on top working :D
2025-07-10 Improved global filtering functions + lots of testing
2025-07-14 Adjusted filtering parameters; moved smoothing into functions
2025-07-16 Bug fix: changed calibration from 1000 micron to 500 micron
2025-07-16 Github broke or something
    So I brute force uploaded all changes. Couldn't get neighbour filtering with alternative peak candidates and/or intensity thresholding working, so had to revert :(
2025-07-21 SprayTec tests
    [250721_1041_test.csv, 250721_1101_test.csv]
2025-07-23 Neighbour filtering fixed, better validation, replacing implemented but not tested
2025-07-23 PIV 250723
    [250723_1517_PIV_1.5bar.csv, 250723_1628_1dot5bar_closedtank.csv, 250723_1638_1bar_refill.csv, 250723_1657_2bar_refill.csv, 250723_1706_2barclosedtank.csv, 250723_1711_1barclosedtank.csv]
2025-07-24 Added different filtering modes
2025-07-27 Multi-threaded image readout
2025-07-27 Updated for multi-threading (reading from local disk); sliding window sum of correlation maps for first pass implemented
2025-07-28 Multi-threaded everything!!!
2025-07-28 Neighbour filtering functions to take in central value for consistency; added back overlap functionality
2025-07-30 First PEO experiment using Spraytec correct way
    [250729_1241_0dot25_80ms_1dot5bar.csv]
2025-07-30 New calibration; added plot & export of all data
2025-07-30 Moved calibration to main module
2025-07-30 Neighbour filter timing
2025-07-30 Moved old calibration file
2025-08-01 Frame size x and y were reversed. Fixed but not yet re-run!
2025-08-01 Added full calibration procedure to PIV flow
2025-08-01 Calculate, plot & save flow rate
2025-08-01 measurements 01-08-25
    [250801_1604_2bar80msPEO_0dot25_1dot5ml_1.csv, 250801_1734_PEO0dot25_1dot5bar_1dot5ml_1.csv, 250801_1807_1dot5bar_0dot25PEO_1dot5ml_2.csv]
2025-08-04 Measurements 4aug
    [250804_1156_PEO0dot25_4.csv, 250804_1228_PEO0dot25_5.csv, 250804_1650_PEO0dot25_6.csv, 250804_1710_PEO0dot25_7.csv]
2025-08-06 Measurements 6aug
    [250805_0954_scrapertest_PEO0dot25_1dot5ml_1dot5bar.csv, 250806_0935_PEO0dot25_8.csv, 250806_1025_PEO0dot25_9.csv, 250806_1147_PEO_0dot25_10.csv]
2025-08-06 Spraytec averaging. And also full averaging. Only the time they start seems wrong
    [PEO_0dot25_1dot5ml_1dot5bar_80ms.csv]
2025-08-07 Fixed the t_start bug. Now it shows the correct times
    [PEO_0dot25_1dot5ml_1dot5bar_80ms.csv]
2025-08-07 Measurements 7aug
    [250807_1221_PEO0dot03_1.csv, 250807_1347_PEO0dot03_2.csv, 250807_1403_PEO0dot03_3.csv, 250807_1512_PEO0dot03_4.csv, 250807_1608_PEO0dot03_5.csv, 250807_1628_PEO0dot03_6.csv, 250807_1643_PEO0dot03_7_1ml.csv, 250807_1654_PEO0dot03_8_shortrelaxation.csv]
2025-08-08 Switched to .svg added some stats like number_records Structured the data more. See Spraytecprocessing.txt for details on how the protocol works
    [PEO_0dot03_1dot5ml_1dot5bar_80ms.csv, PEO_0dot25_1dot5ml_1dot5bar_80ms.csv]
2025-08-08 PEO 0dot03 measurements 08-08-2025
    [250808_1447_PEO0dot03_9.csv]
2025-08-08 added analysis of measurements 08082025
    [PEO_0dot03_1dot5ml_1dot5bar_80ms.csv]
2025-08-08 PEO 0dot03_11 measurement (looked great) 08-08-2025
    [250808_1538_PEO0dot03_11.csv]
2025-08-21 measurement series PEO2M 1 percent 1.5ml 1.5bar 80 ms
    [250821_1601_PEO1percent_1.csv, 250821_1612_PEO_1percent_2.csv, 250821_1625_PEO1percent_3.csv, 250821_1636_PEO_1percent_4.csv, 250821_1651_PEO_1percent_5.csv, 250821_1701_PEO1percent_6.csv, 250821_1718_PEO1percent_7.csv, 250821_1728_PEO_1percent_8.csv]
2025-08-21 New mesaurement series of PEO 1 percent analyzed plus some changes to scripts
    [PEO_0dot03_1dot5ml_1dot5bar_80ms.csv, PEO_1percent_1dot5ml_1dot5bar_80ms.csv]
2025-08-23 Added cihx file reader (thanks AI) because I got annoyed with trying to find specific camera settings
2025-08-25 Moving old files on Github to archive
    [250305_1435_2_5bar_50ms.csv, 250324_1028_ETPoF_1-32_1.csv, 250324_1048_ETPoF_1-32_2.csv, 250324_1057_ETPoF_1-32_3.csv, 250324_1137_ETPoF_1-8_1.csv, 250324_1143_ETPoF_1-8_2.csv, 250324_1149_ETPoF_1-8_2.csv, 250324_1152_ETPoF_1-8_3.csv]
2025-08-25 added the filament width folder, might not completely work yet, but it has done the job in the past
2025-08-29 measurement series PEO2M 0.25percent 1bar and start of 1.25bar
    [250829_1155_PEO0dot25_1bar_1.csv, 250829_1208_PEO0dot25_1bar_2.csv, 250829_1219_PEO0dot25_1bar_3.csv, 250829_1433_PEO0dot25_1bar_4.csv, 250829_1442_PEO0dot25_1bar_5.csv, 250829_1635_PEO0dot25_1bar_7.csv, 250829_1648_PEO0dot25_1bar_8.csv, 250829_1702_PEO0dot25_1bar_9.csv]
2025-09-01 measurement series PEO2M 0.25percent 1dot25 bar finished and 1ml
    [250901_1401_PEO0dot25_1dot25bar_5.csv, 250901_1411_PEO0dot25_1dot25bar_6.csv, 250901_1422_PEO0dot25_1dot25bar_7.csv, 250901_1442_PEO0dot25_1dot25bar_8.csv, 250901_1452_PEO0dot25_1dot25bar_9.csv, 250901_1501_PEO0dot25_1dot25bar_10.csv, 250901_1612_PEO0dot25_1ml_1.csv, 250901_1621_PEO0dot25_1ml_2.csv]
2025-09-02 measurement series water started
    [250902_1139_water_1.csv, 250902_1159_water_2.csv, 250902_1209_water_3.csv, 250902_1219_water_4.csv, 250902_1543_water_1ml_1.csv, 250902_1554_water_1ml_2.csv, 250902_1604_water_1ml_3.csv, 250902_1614_water_1ml_4.csv]
2025-09-03 measurement series water
    [250903_1150_water_1ml_5.csv, 250903_1201_water_1ml_6.csv, 250903_1213_water_1ml_7.csv, 250903_1221_water_1ml_8.csv, 250903_1446_water_1ml_9.csv, 250903_1457_water_1ml_10.csv, 250903_1551_water_1ml_11.csv, 250903_1600_water_1ml_12.csv]
2025-09-09 Newplots! Preparing for final measurement presentation of 11september 2025
    [PEO600K_0dot2_1ml_1dot5bar_80ms.csv, PEO_0dot03_1dot5ml_1dot5bar_80ms.csv, PEO_0dot25_1dot5ml_1bar_80ms.csv, PEO_0dot25_1dot5ml_1dot25bar_80ms.csv, PEO_0dot25_1dot5ml_1dot5bar_80ms.csv, PEO_0dot25_1ml_1dot5bar_80ms.csv, PEO_0dot25_2cmlower_1ml_1dot5bar_80ms.csv, PEOjet.csv]
2025-09-16 all coughs in one figure
    [Results_Feinstein.csv, Results_Flowmeter_r.csv, Results_Gupta.csv, Results_King.csv, Results_Knudson.csv, Results_Mahajan.csv, Results_Ross.csv, Results_Smith_r.csv]
2025-09-17 Added camera trigger & reworked valve trigger
    [valve_control.ino]
2025-09-17 Simplified stage machine
2025-09-17 Some more renaming of variables; stage machine fix and use of microseconds
    [valve_control.ino]
2025-09-17 Solved logic and compiling errors
    [valve_control.ino]
2025-09-22 Some PIV comparisons
    [Results_PIV.csv, Results_flowmeter.csv]
2025-09-22 frames for tommie
2025-09-24 Frame skip and model skip options added
2025-09-24 Frame skip and model skip options added; reran @ 1ms time resolution
2025-09-26 dimensionlessnumbers, morgan her data as individual measurements, and correct morgan comparison shown
    [calculatingdimensionlessnumbers.xlsx]
2025-09-27 PIV filter visualized
2025-09-30 filament_width folder sorted by Abe. Added readme
2025-09-30 other stuff for thesis Abe
    [Results_Smith_r.csv]
2025-09-30 moved typical cough modelling to archive
    [250203_1635_1bar_200ms.csv, 250203_1636_1bar_200ms.csv, 250203_1637_1.5bar_200ms.csv, 250203_1648_2bar_60ms.csv, 250203_1648_2bar_80ms.csv, 250203_1649_2bar_100ms.csv, 250203_1650_1.75bar_100ms.csv, 250203_1650_1.75bar_60ms.csv]
2025-09-30 Last cleanup, added comment to valve control to be carefull with the spraytec append file function in valvecontrol
2025-10-02 Kleine aanpassingen voor mode en filament widths plotjes
2025-10-02 dimensionless numbers van Morgan
    [calculatingdimensionlessnumbers.xlsx]
2025-10-07 Just a lof of small changes
    [calculatingdimensionlessnumbers.xlsx]
2025-10-21 Refactor error handling: remove ERROR state and replace with printError function
    [main.cpp]
2025-10-21 Now use DotStar led for showing state; included library
2025-10-21 Add debug print statements, help menu and current status command
2025-10-21 Update error led color; readings now return led color to previous state
    [main.cpp]
2025-11-14 Generalised laser-to-valve delay so it also applies before the O command
2025-11-18 Increased pda threshold voltage
2025-11-20 Set valve open delay; bunch of logs for testing purposes
2025-11-20 Pump connection working
2025-11-20 Simplified state flags and timer variables
2025-11-20 Droplet detection + pump + valve integration test
2025-11-20 Allow dripping n droplets; plot pressure in time
2025-11-20 Fixed some serial bugs, plotted some things for tests
    [dripping_droplets.py]
2025-11-20 Renamed source folders
    [250324_1603_test.csv, 250328_1356_test.csv, 250328_1357_test.csv, 250328_1358_test.csv, 250417_1342_test.csv, 250512_1226_test.csv, 250512_1228_test.csv, 250512_1233_test.csv]
2025-11-27 Uploaded pictures of electronics boards
2025-11-27 Start at wiring diagram
2025-11-27 Power supplies datasheets
2025-12-05 Visual fixes; corrected T-click circuit
2025-12-05 Started adding pressure regulator circuits; more visual tweaks
2025-12-12 Many updates from handwritten notes; still working on pump cable
2025-12-14 Add set proportional valve value <mA> functionality
2025-12-14 Add set pressure regulator value functionality
2025-12-14 Add reset data arrays functionality
    [main.cpp]
2025-12-15 Add example flow curve
    [drawn_curve.csv]
2025-12-15 Bit of progress on pump cable
2025-12-16 Add flowcurve duration variable to handshake
2025-12-16 Integrated valve timing, system state prints, bug fixes
    [main.cpp]
2025-12-16 Working valve timing.
2025-12-16 Finished pump connection
2025-12-17 Add debug print last set bitval R and T clicks
2025-12-17 Bug fix print bitvalue t clicks
    [main.cpp]
2025-12-17 Fixed uint32_t and int32_t comparison valve timing
    [main.cpp]
2025-12-17 Removed old wiring diagram; added info on pressure regulator presets, fixed internal links in Readme; removed docs of wrong valve coil
2025-12-17 Fixed valve timing sequence
    [main.cpp]
2025-12-17 Fixed trigger stop timing
    [main.cpp]
2025-12-17 Added common syringe diameters
2025-12-18 RT click calibration values added to docs; small fixes
2025-12-18 Updated RT clicks calibration plots
2025-12-18 (Re)calibrated R click and T click, updated script to handle both; set pressure now in bar; bunch of autoformatting
2026-01-02 Add read pressure function
2026-01-02 sligth change to pressure reading function
2026-01-02 create new valve control file
2026-01-03 First version, missing data retreival from MCU
    [new_valve_control.py]
2026-01-03 Add record solenoid valve event
2026-01-04 Add serial read ignore errors
    [main.cpp]
2026-01-05 Add correct Flash memory initialization
    [main.cpp, send_data.py]
2026-01-05 Pump cable connections; worked out more electronics details; now links to all pdfs
2026-01-05 Fixed typos; moved pump connection to Readme; export as png now
2026-01-05 Bug fixes
    [drawn_curve.csv]
2026-01-06 Fix prop valve open sys state check & bug fixes
    [main.cpp]
2026-01-07 Moved spraytec files, dripping tests and processed PIV to folder that will be incorporated into local data
    [PEO600K_0dot2_1ml_1dot5bar_80ms.csv, PEO_0dot03_1dot5ml_1dot5bar_80ms.csv, PEO_0dot25_1dot5ml_1bar_80ms.csv, PEO_0dot25_1dot5ml_1dot25bar_80ms.csv, PEO_0dot25_1dot5ml_1dot5bar_80ms.csv, PEO_0dot25_1ml_1dot5bar_80ms.csv, PEO_0dot25_2cmlower_1ml_1dot5bar_80ms.csv, PEO_1percent_1dot5ml_1dot5bar_80ms.csv]
2026-01-07 Moved calibration data to docs, updated calibration function accordingly and added utility function for timestamp generation
2026-01-07 Moved calibration script, improved (meta)data file generation and generalised file dialog utilities
    [Rclick_calibration_20251219_213025_calibration.csv, Tclick_calibration_20251219_213025_calibration.csv]
2026-01-07 Moved old valve control runs to be sorted in local data later
    [250324_1603_test.csv, 250328_1356_test.csv, 250328_1357_test.csv, 250328_1358_test.csv, 250417_1342_test.csv, 250512_1226_test.csv, 250512_1228_test.csv, 250512_1233_test.csv]
2026-01-07 Moved Abe's results from src_python
    [2_5bar50ms.csv]
2026-01-07 Moved data back into SprayTec folder
    [PEO600K_0dot2_1ml_1dot5bar_80ms.csv, PEO_0dot03_1dot5ml_1dot5bar_80ms.csv, PEO_0dot25_1dot5ml_1bar_80ms.csv, PEO_0dot25_1dot5ml_1dot25bar_80ms.csv, PEO_0dot25_1dot5ml_1dot5bar_80ms.csv, PEO_0dot25_1ml_1dot5bar_80ms.csv, PEO_0dot25_2cmlower_1ml_1dot5bar_80ms.csv, PEO_1percent_1dot5ml_1dot5bar_80ms.csv]
2026-01-07 Moved cvd check, and new io_utils and time_utils to tcm-utils repo. Tested using updated pressure_calibration
2026-01-07 Removed old pumpy copies; missed function file_dialogs that was moved to tcm-utils
2026-01-07 Moved piv, video analysis and droplet size analysis scripts to respective repos
    [PEO600K_0dot2_1ml_1dot5bar_80ms.csv, PEO_0dot03_1dot5ml_1dot5bar_80ms.csv, PEO_0dot25_1dot5ml_1bar_80ms.csv, PEO_0dot25_1dot5ml_1dot25bar_80ms.csv, PEO_0dot25_1dot5ml_1dot5bar_80ms.csv, PEO_0dot25_1ml_1dot5bar_80ms.csv, PEO_0dot25_2cmlower_1ml_1dot5bar_80ms.csv, PEO_1percent_1dot5ml_1dot5bar_80ms.csv]
2026-01-07 Moved more data to to-local-folder, move (obsolete) flowmeter settings to docs; deleted old arduino tests
    [250305_1435_2_5bar_50ms.csv, 250324_1028_ETPoF_1-32_1.csv, 250324_1048_ETPoF_1-32_2.csv, 250324_1057_ETPoF_1-32_3.csv, 250324_1137_ETPoF_1-8_1.csv, 250324_1143_ETPoF_1-8_2.csv, 250324_1149_ETPoF_1-8_2.csv, 250324_1152_ETPoF_1-8_3.csv]
2026-01-07 Dumped part of cough modelling stuff in utils repo
    [250203_1635_1bar_200ms.csv, 250203_1636_1bar_200ms.csv, 250203_1637_1.5bar_200ms.csv, 250203_1648_2bar_60ms.csv, 250203_1648_2bar_80ms.csv, 250203_1649_2bar_100ms.csv, 250203_1650_1.75bar_100ms.csv, 250203_1650_1.75bar_60ms.csv]
2026-01-08 Add record pressure logging sol valve action
2026-01-08 Moved out more of the modelling/example cough stuff
    [Results_Feinstein.csv, Results_Flowmeter_r.csv, Results_Gupta.csv, Results_King.csv, Results_Knudson.csv, Results_Mahajan.csv, Results_Ross.csv, Results_Smith_r.csv]
2026-01-08 Add json header file and bug fixes
    [PyramidFlowProfile.csv, drawn_curve.csv]
2026-01-12 Add pump initialization
2026-01-16 Working json config
    [default.csv]
2026-01-16 flow profile csv transfer
    [RampFlowProfile.csv, default_curve.csv]
2026-01-27 Festo Valve 2 Setpoint Current to Flow Rate Relation
2026-01-28 Calibrated flow curve test code
